Wilewee/A3EPS/Firmware/README.md

All STM32 code goes here
TODO: Write something meaningful here
