Wilewee/A3EPS/PCB_Design/1 _ fixed with 07mm vias/FULL_PCBs/FINAL/1/info.txt

Tilauksen tiedot:

Designit:
PCB1.zip ja PCB2.zip (gerberit)
Molemmista 5kpl kopioita

 levyn koko < 100mm x 100mm 
 paksuus 1.6mm
 kuparin paksuus 35 µm (halvin)
 kerroksia 2
 Pienin läpiviennin reikä 0.7mm

 Ei JEP:tta tai kuvioita
 Ei panelointia tai sahausta
