Wilewee/A3EPS/Documentation/EPS_IO_pins.txt

// Boost input (ADC)
I1_IN
I2_IN
I3_IN

V1_IN
V2_IN
V3_IN

// Boost output (ADC)
I1_OUT
I2_OUT
I3_OUT

// Bus output (ADC)
I_5V_BUS
I_3V6_BUS

I_BATT1
I_BATT2

// Battery temperature (ADC)
TEMP_BATT1
TEMP_BATT2

// Switch (GPIO)
MAIN_PWR_SW

BATT1_BUS_SW
BATT2_BUS_SW

5V_BUS_SW
3V6_BUS_SW

// DAC (I2C)
SDA
SCL
LDAC (GPIO)

// CAN
CAN1_H
CAN1_L

CAN2_H
CAN2_L

// Debug
SWCLK
SWDIO
NRST

USART_TX
USART_RX

// Oscillator
RCC_OSC_IN
RCC_OSC_OUT
