Wilewee/A3EPS/Documentation/Flowchart.png

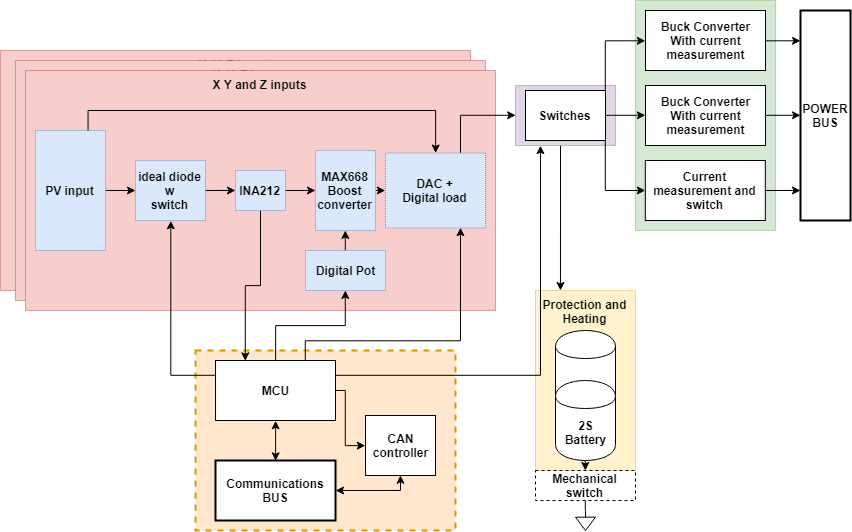
Documentation/Flowchart.png
