Wilewee/A3EPS/EPS/BOM1.png

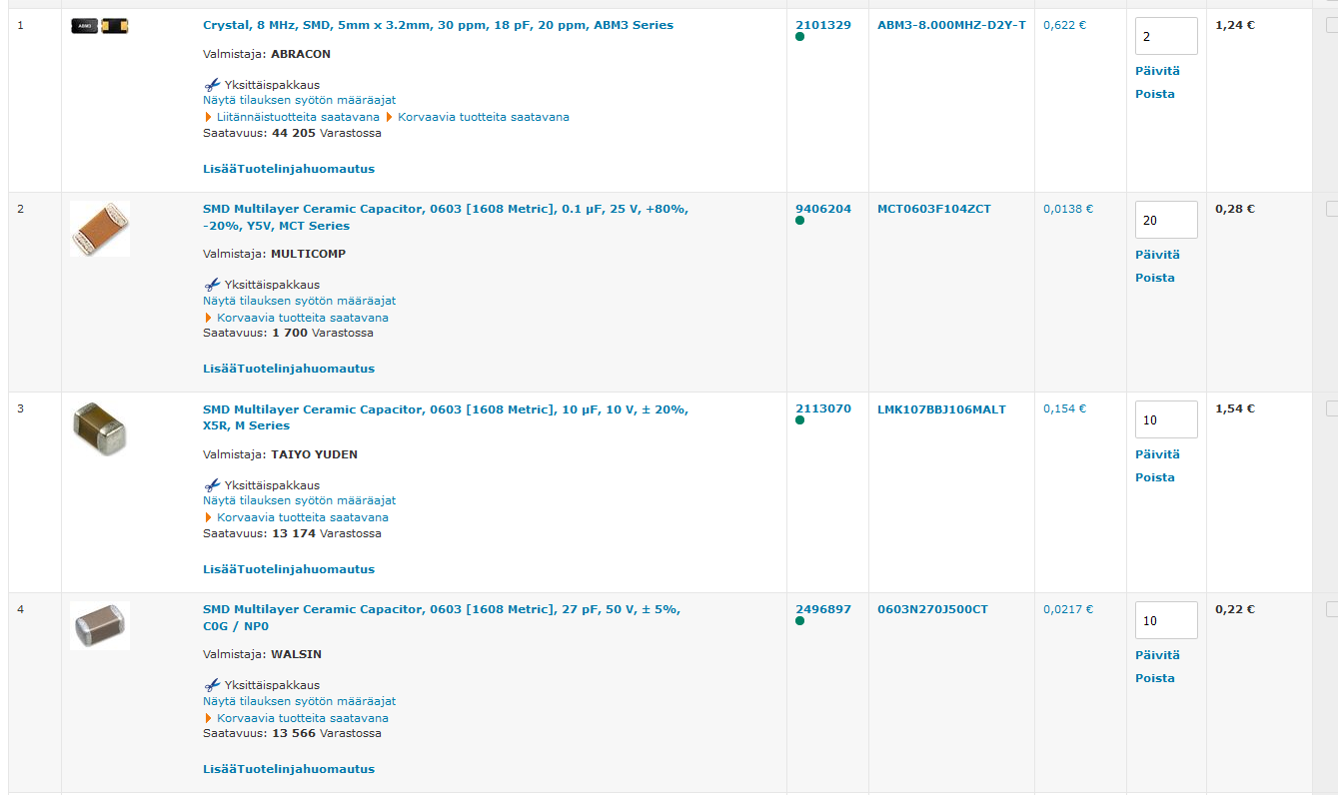
EPS/BOM1.png
