Wilewee/A3EPS/EPS/BOM3.png

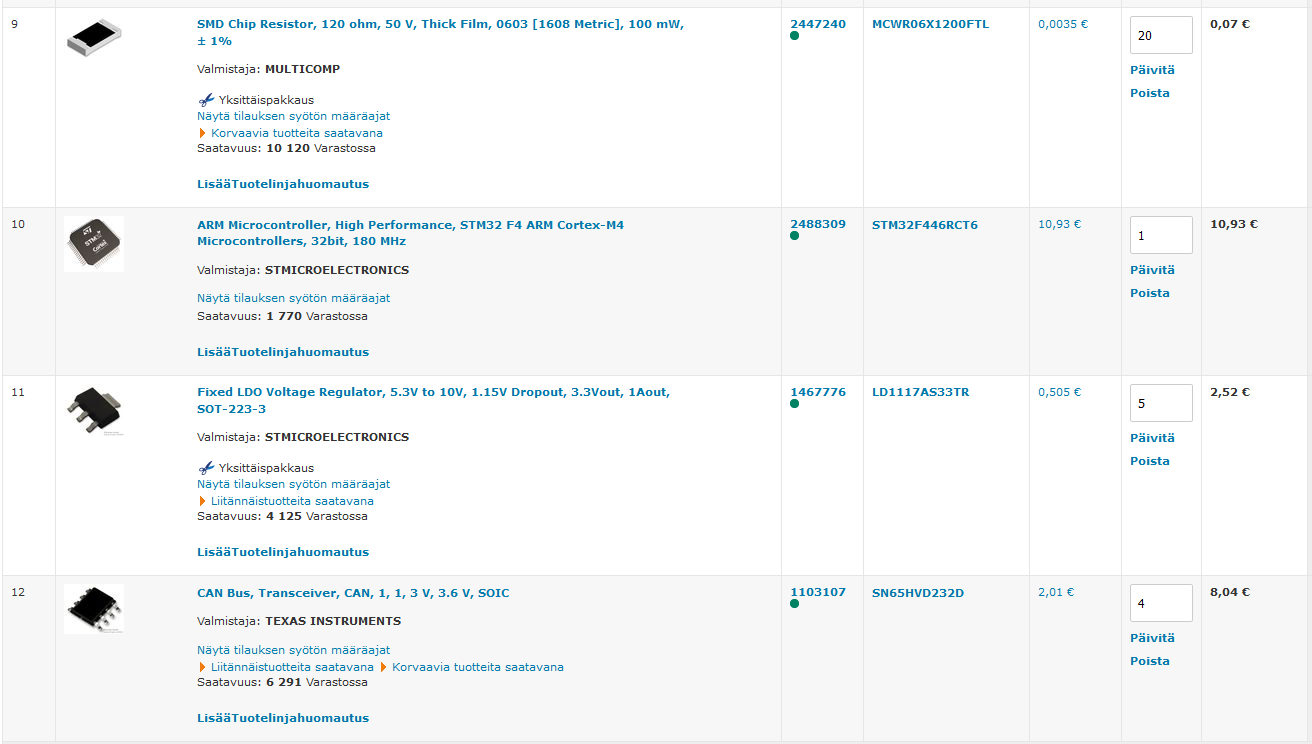
EPS/BOM3.png
