Wilewee/A3EPS/PCB_Design/1 _ fixed with 07mm vias/max1771_BOOST/nighthawk250v4propguardL.stl

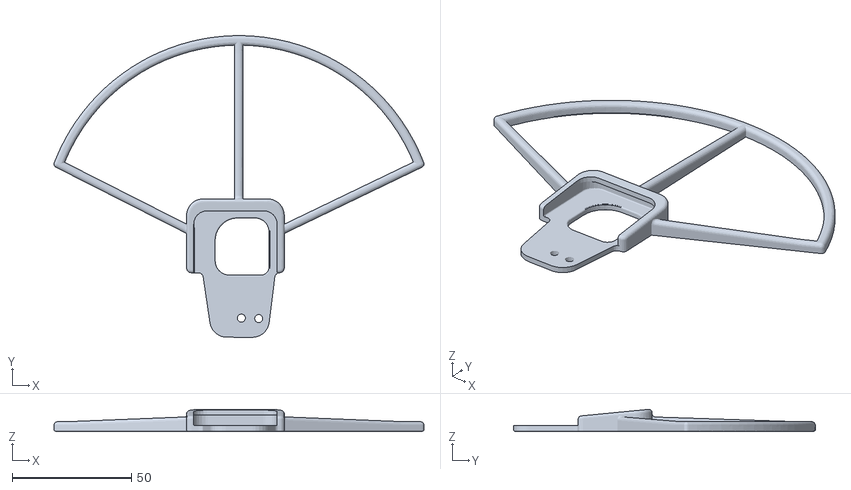
[picture p4: CAD file, 2018-01-24]
PCB_Design/1 _ fixed with 07mm vias/max1771_BOOST/nighthawk250v4propguardL.stl
155.2 x 126.6 x 9.37
