Wilewee/A3EPS/PCB_Design/1 _ fixed with 07mm vias/INA139/pdf/INA139.pdf

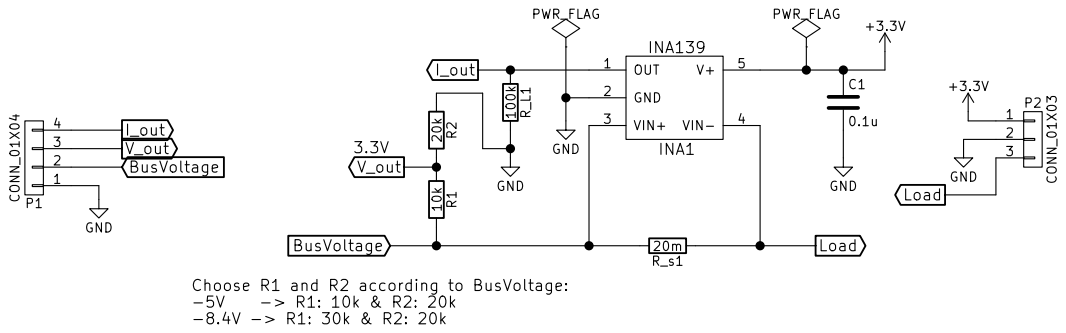
[picture p5: page 1]

PWR_FLAG Choose R1 and R2 according to BusVoltage: -5V -> R1: 10k & R2: 20k

Id: 1/1 Title: INA139 & Voltage Divider for Voltage Measurement File: INA139.sch Sheet: /
