Wilewee/A3EPS/PCB_Design/1 _ fixed with 07mm vias/max1771_BOOST/max1771-F.Cu.pdf

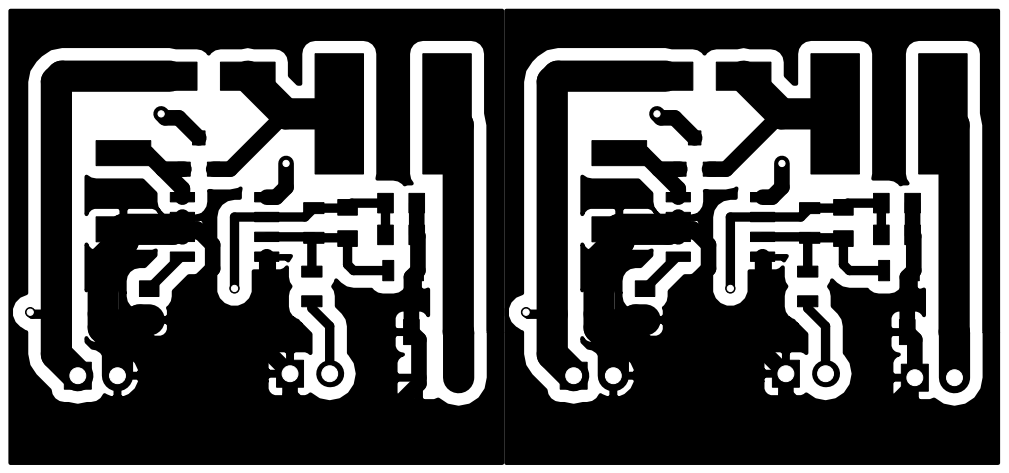
[picture p6: page 1]
