Wilewee/A3EPS/PCB_Design/1 _ fixed with 07mm vias/Max668_BOOST/Max668_2-B.Cu.pdf

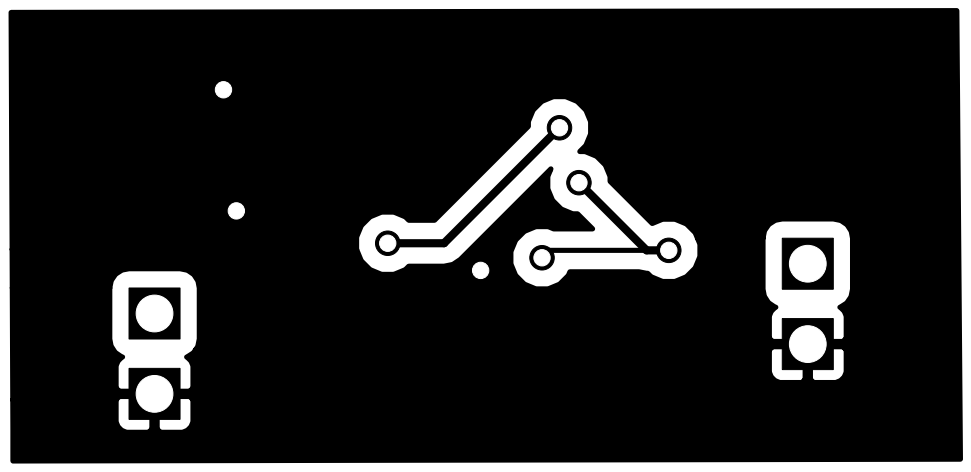
[picture p7: page 1]
