Wilewee/A3EPS/PCB_Design/1 _ fixed with 07mm vias/Max668_BOOST/Max668_2-F.Cu.pdf

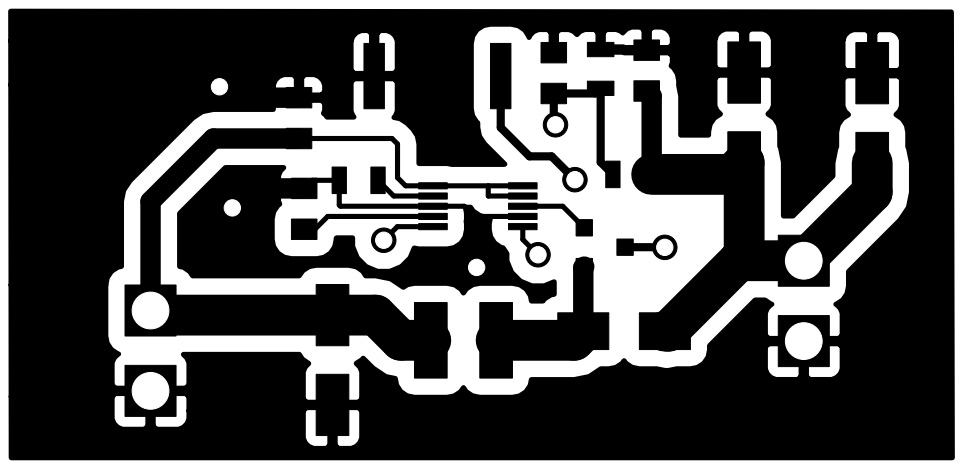
[picture p8: page 1]
