Wilewee/A3EPS/PCB_Design/1 _ fixed with 07mm vias/INA220_DAC121C081/pdf/INA220_DAC121C081.pdf

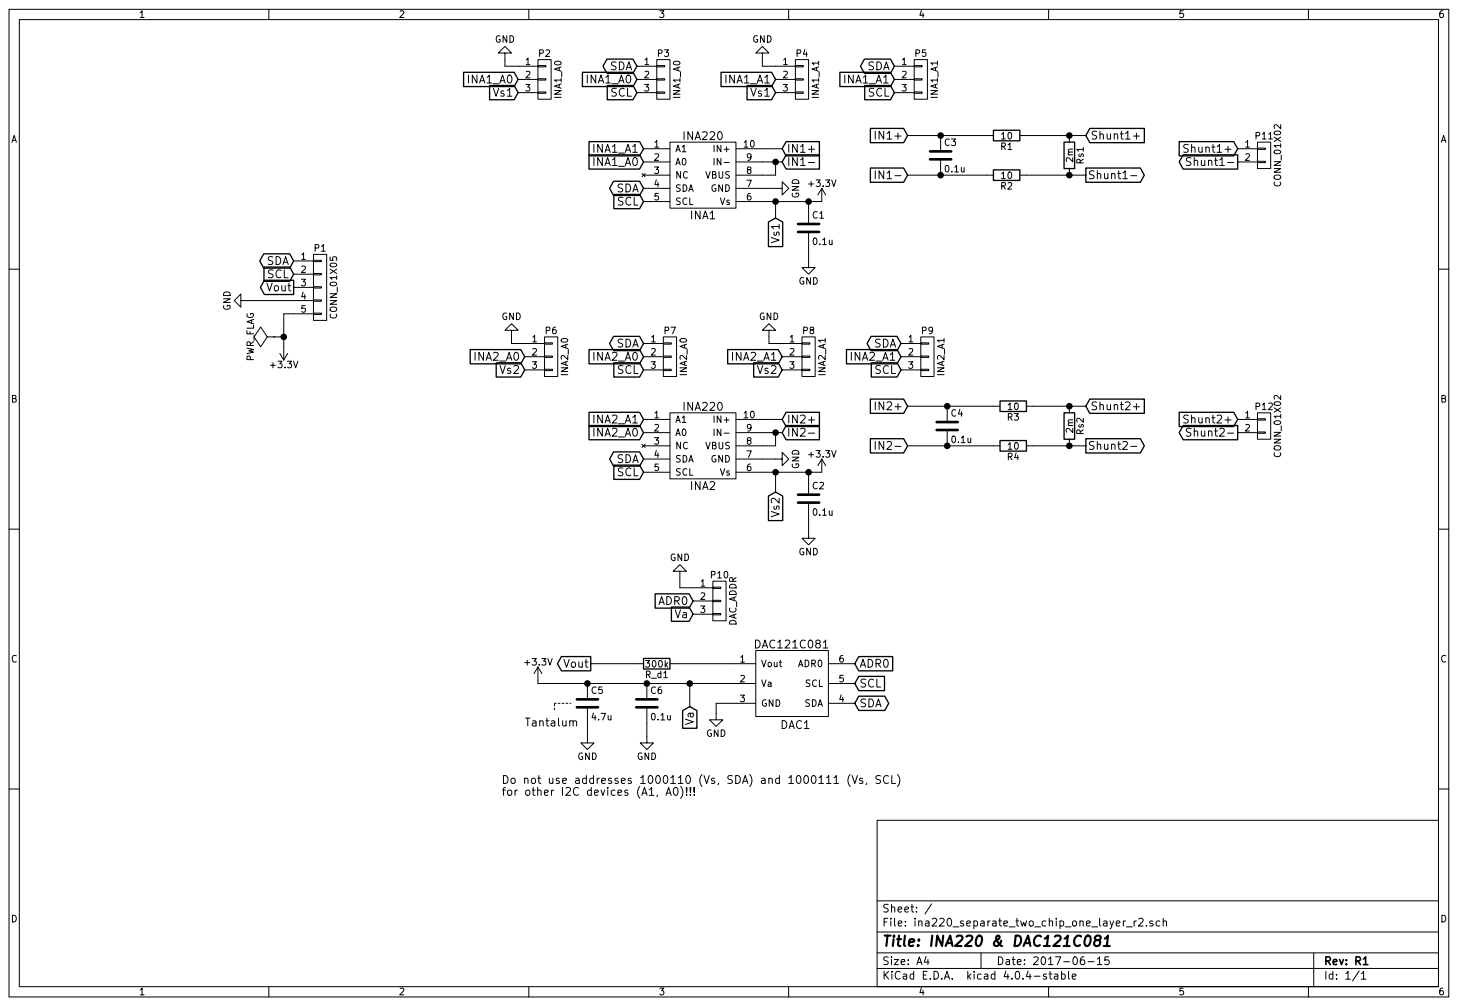
[picture p9: page 1]
