Wilewee/A3EPS/PCB_Design/1 _ fixed with 07mm vias/LT3080_and_CAN_transceiver/pdf/LT3080_and_CAN_transceiver.pdf

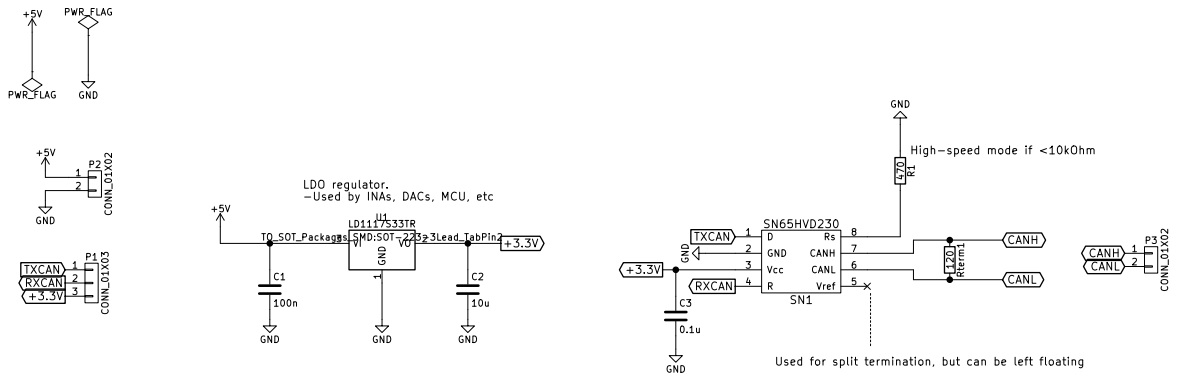
[picture p10: page 1]

Used for split termination, but can be left floating
