Wilewee/A3EPS/PCB_Design/1 _ fixed with 07mm vias/max1771_BOOST/negative/max1771-F.Cu.pdf

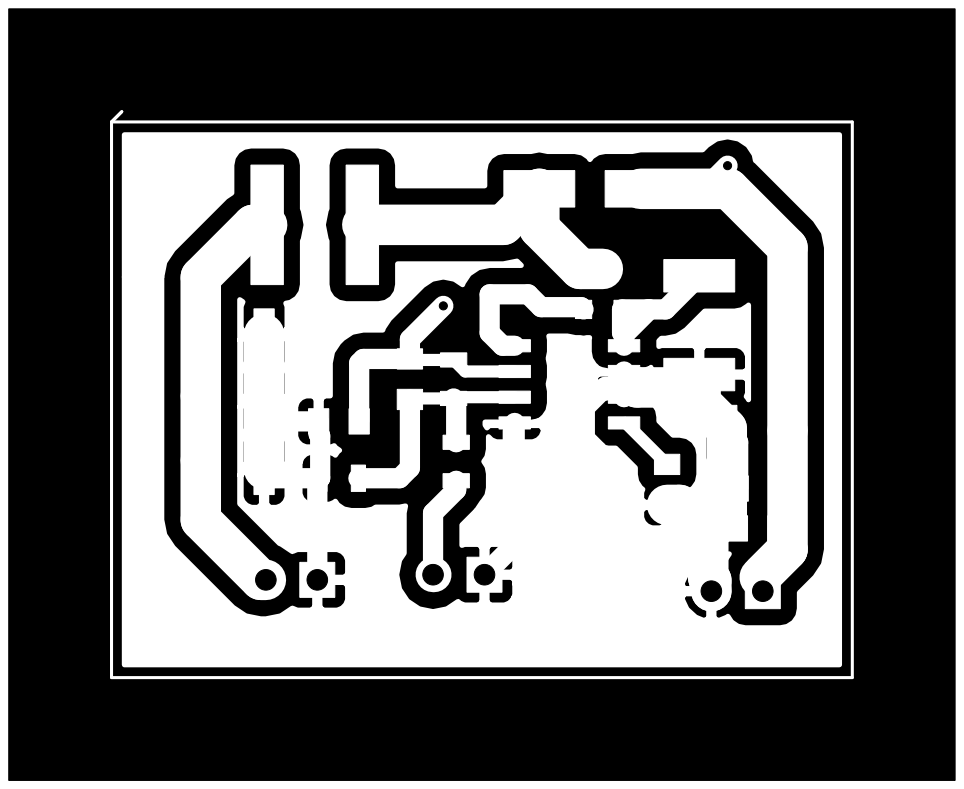
[picture p11: page 1]
