Wilewee/A3EPS/EPS/CAN_transceivers-STM32_block-CAN_transceivers.pdf

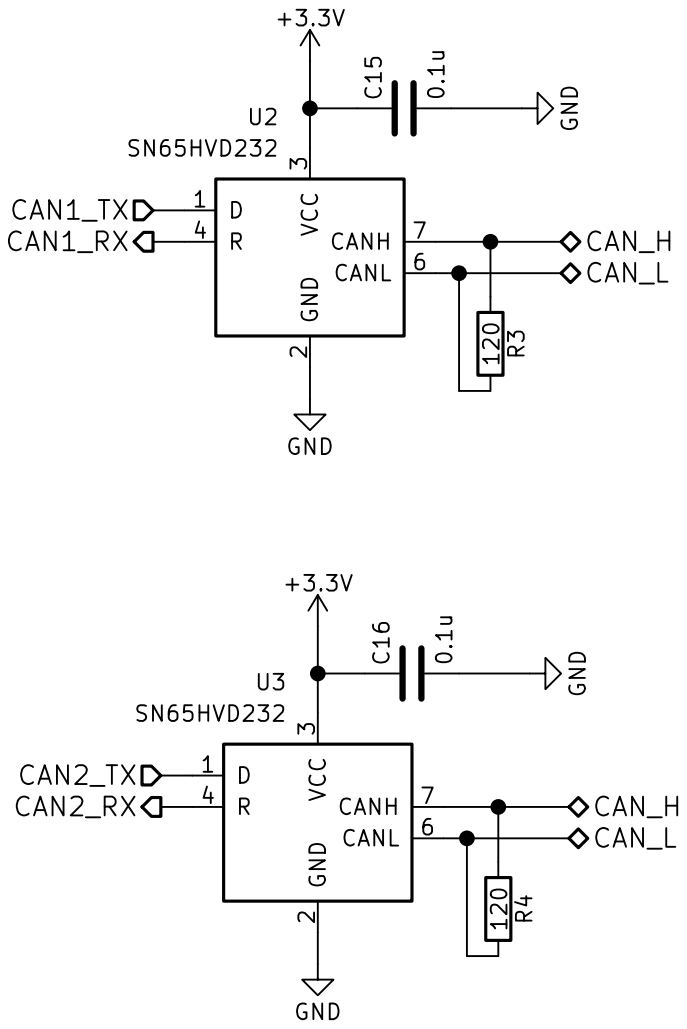
[picture p12: page 1]
