Wilewee/A3EPS/EPS/STM32_block-STM32_block.pdf

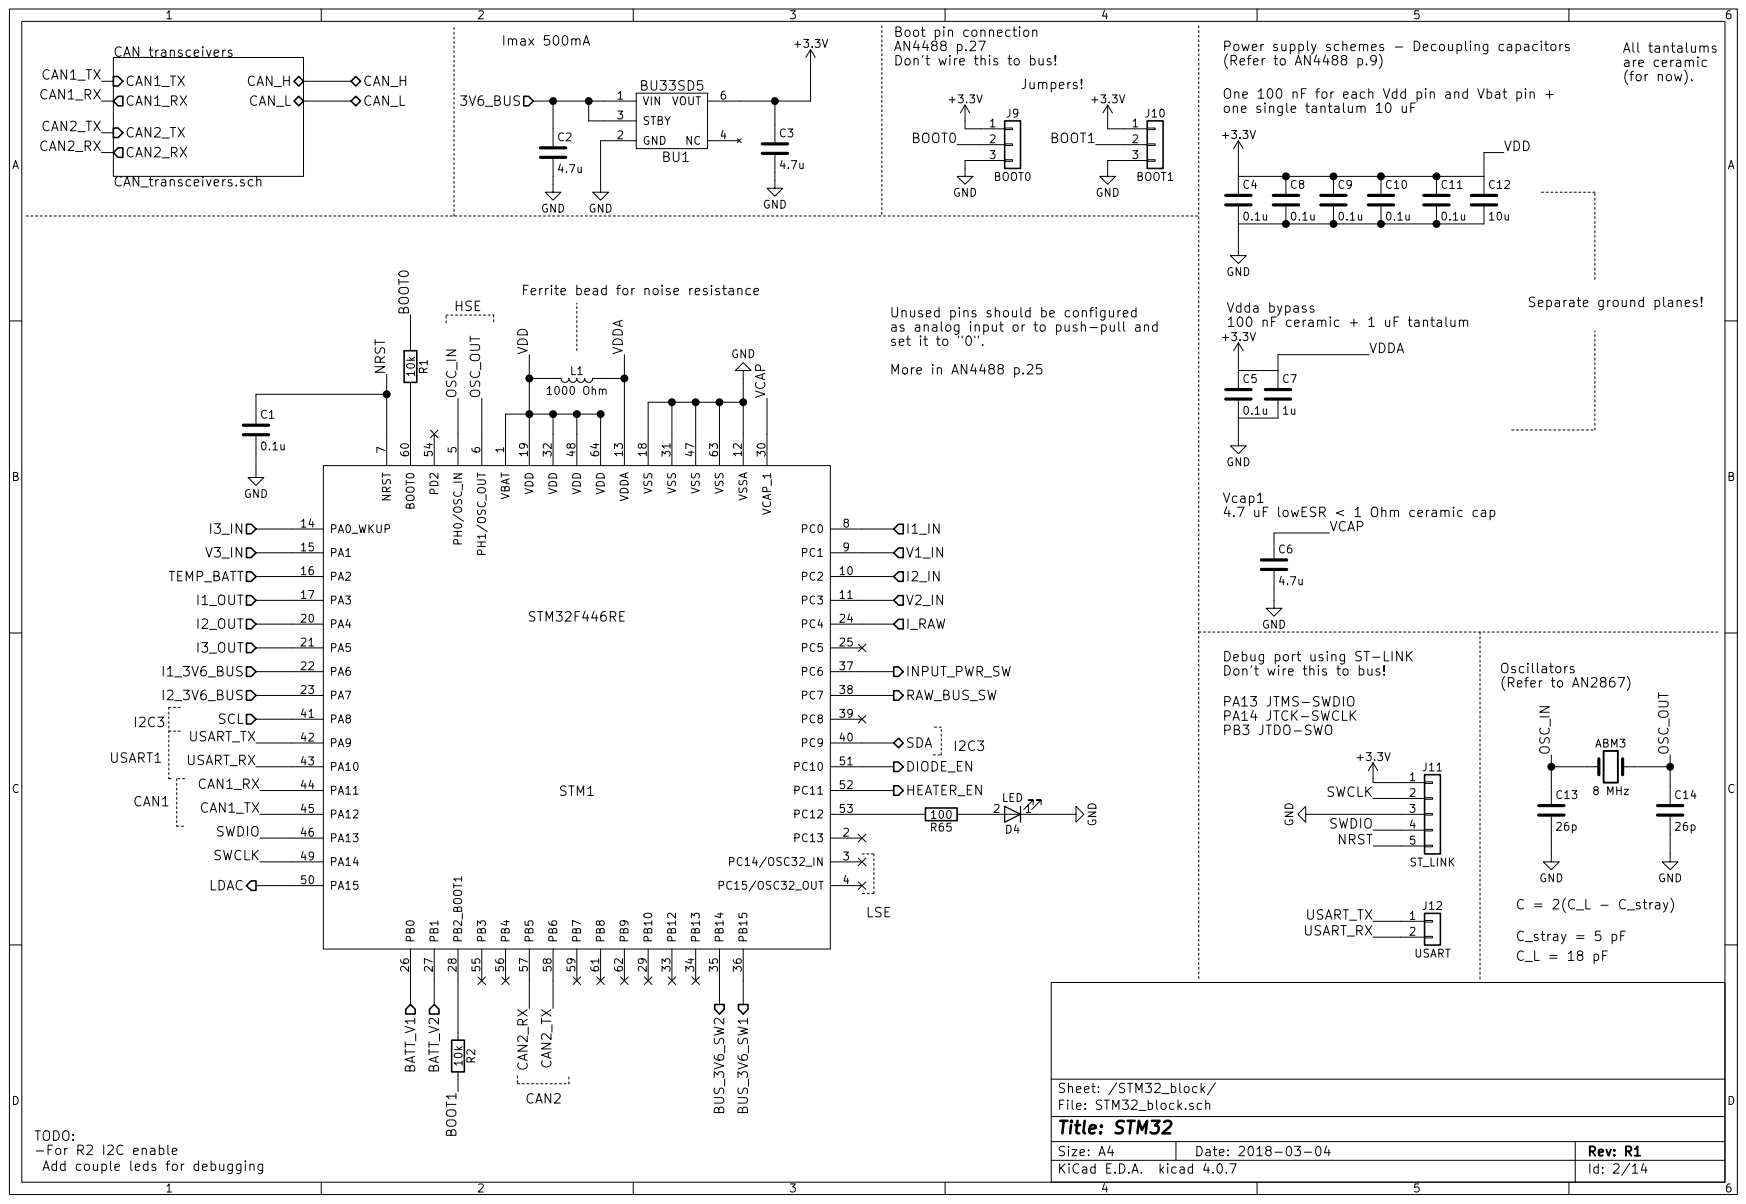
[picture p13: page 1]
