Wilewee/A3EPS/PCB_Design/FULL_PCB/Full_PCB.kicad_pcb

## KiCad design PCB_Design/FULL_PCB/Full_PCB.kicad_pcb (2018-02-04)

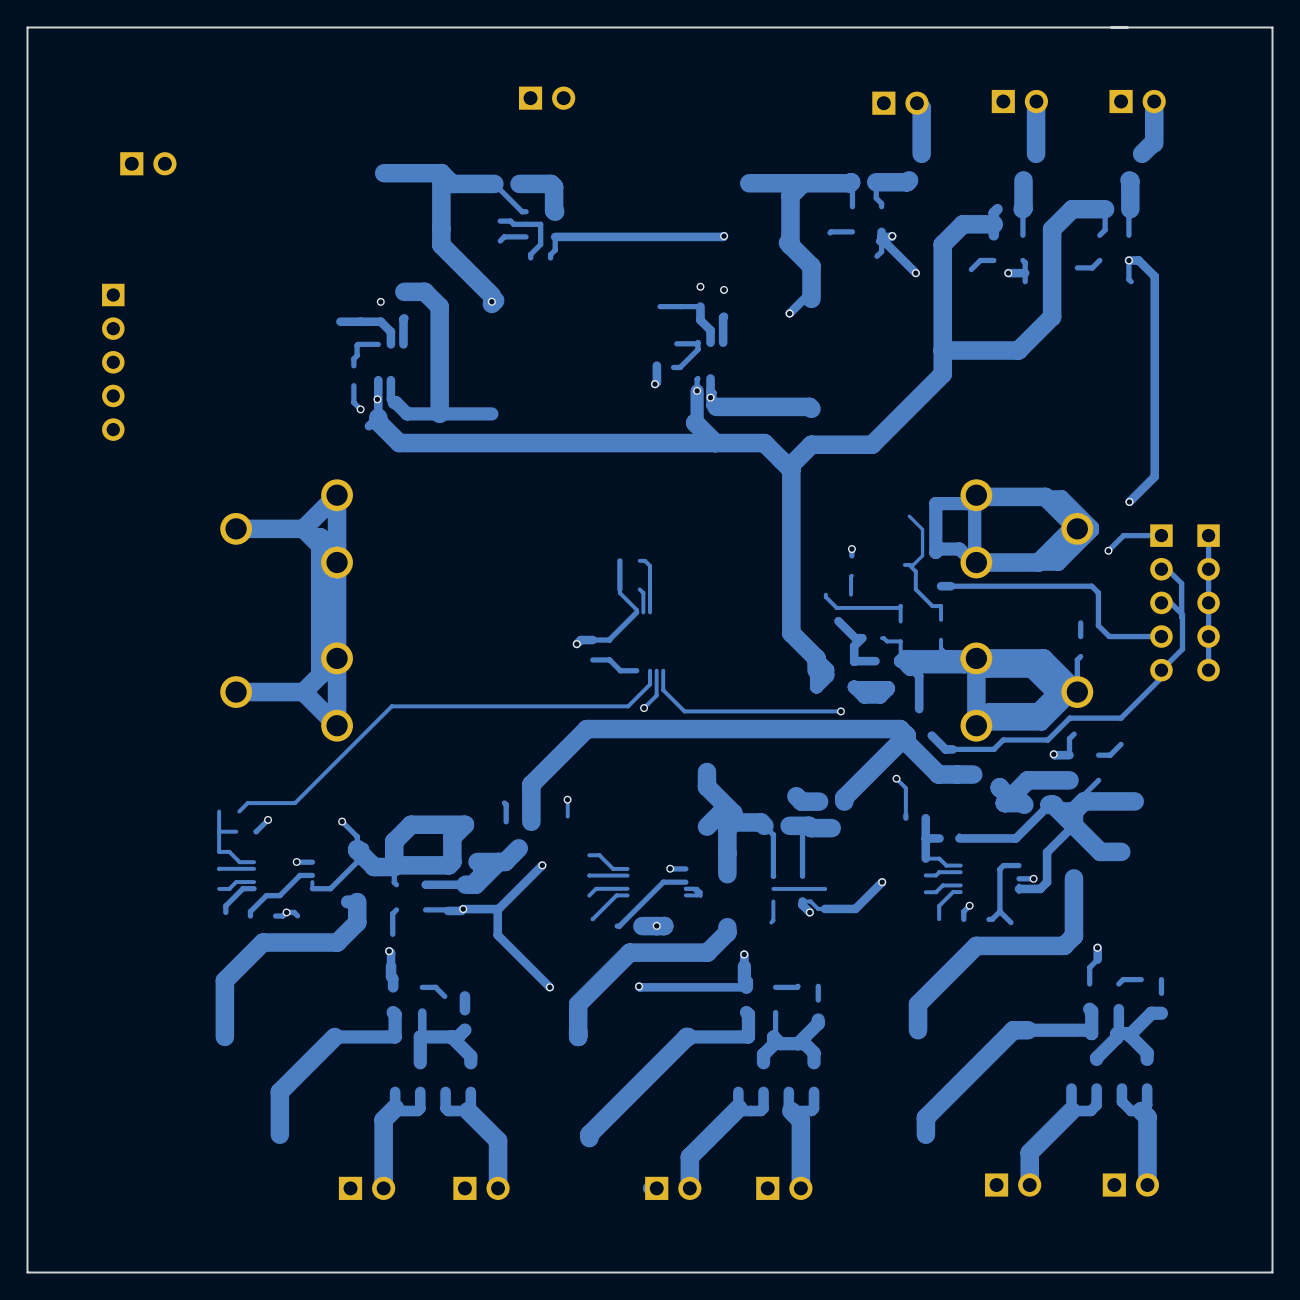
[picture p16: board Full_PCB.kicad_pcb from above]

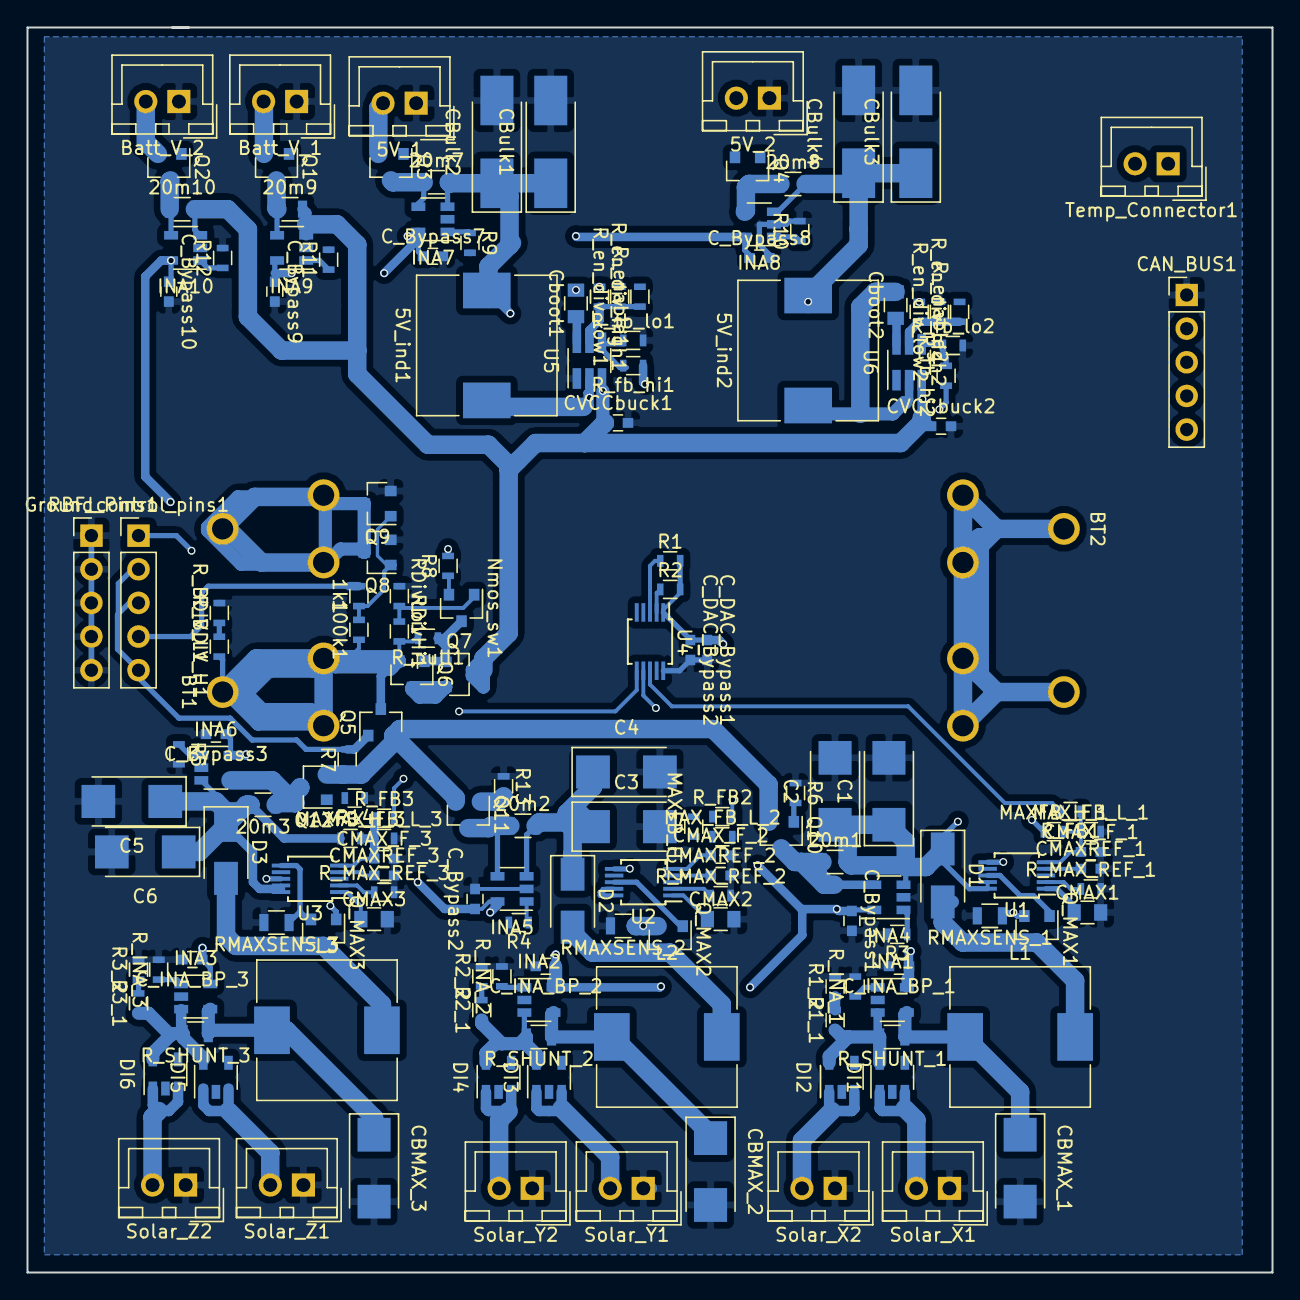
[picture p17: board Full_PCB.kicad_pcb from below]

Board: 4 copper layers, 94.0 x 94.0 mm, 165 parts (165 on the bottom side), 92 nets.

Parts:
1k1, 100k1: R; R_0603
5V_1, 5V_2: Jst_Conn; JST_XH_B02B-XH-A_02x2.50mm_Straight
5V_ind1, 5V_ind2: 10u; L_10.4x10.4_H4.8
20m1, 20m2, 20m3, 20m7, 20m8, 20m9, 20m10: R_Shunt; R_0805
BT1, BT2: Battery_Cell; 18650_Holder_FULL
Batt_V_1, Batt_V_2: Jst_Conn; JST_XH_B02B-XH-A_02x2.50mm_Straight
C1, C2, C3, C4, C5, C6: CP; CP_Tantalum_Case-C_EIA-6032-28_Reflow
CAN_BUS1: 5_pin_2.56; Socket_Strip_Straight_1x05_Pitch2.54mm
CBMAX_1, CBMAX_2, CBMAX_3: 68uF; CP_Tantalum_Case-C_EIA-6032-28_Reflow
CBulk1, CBulk2, CBulk3, CBulk4: C; CP_Tantalum_Case-C_EIA-6032-28_Hand
CMAX1, CMAX2, CMAX3: 1uF; C_0805
CMAXREF_1, CMAXREF_2, CMAXREF_3: .22uF; C_0603
CMAX_F_1, CMAX_F_2, CMAX_F_3: 220pF; C_0603
CVCCbuck1, CVCCbuck2: 10u; C_0603
C_Bypass1, C_Bypass2, C_Bypass3, C_Bypass7, C_Bypass8, C_Bypass9, C_Bypass10: .1u; C_0603
C_DAC_Bypass1, C_DAC_Bypass2: C; C_0603
C_INA_BP_1, C_INA_BP_2, C_INA_BP_3: .1u; C_0603
Cboot1, Cboot2: .1uF; C_0805
D1, D2, D3: D_Schottky; D_SMA
DI1, DI2, DI3, DI4, DI5, DI6: MAX40200; SOT-23-5
Ground_Pins1: 2.56_socket_male; Socket_Strip_Straight_1x05_Pitch2.54mm
INA1, INA2, INA3, INA4, INA5, INA6, INA7, INA8, INA9, INA10: INA139; SOT-23-5
L1, L2, L3: L_Small; L_10.4x10.4_H4.8
MAXFB_H_1, MAXFB_H_2, MAXFB_H_3: 100k; R_0603
MAX_FB_L_1, MAX_FB_L_2, MAX_FB_L_3: 22k; R_0603
Nmos_sw1: Logic level Nch mosfet; SOT-23
Q1, Q2, Q3, Q4, Q8, Q9: Q_NMOS_GSD; SOT-23
Q5, Q6, Q7, Q10, Q11, Q12: Q_PMOS_GSD; SOT-23
Q_MAX1, Q_MAX2, Q_MAX3: Q_NMOS_GSD; SOT-23
R1, R2: 10k; R_0603
R1_1, R2_1, R3, R3_1, R4, R5, R9, R10, R11, R12: 100k; R_0603
R1_2, R2_2, R3_2: 200k; R_0603
R6, R13, R14: 220k; R_0603
R7, R8: R; R_0603
RBF_control_pins1: 5_pin_2.56; Socket_Strip_Straight_1x05_Pitch2.54mm
RDivHi1: R; R_0603
RDivLo1: R; R_0603
RMAXSENS_1, RMAXSENS_2, RMAXSENS_3: 0.02; R_0805
R_BDIV_H1: 220k; R_0603
R_BDIV_L1: 100k; R_0603
R_FB1, R_FB2, R_FB3: 100k; R_0603
R_INA_1, R_INA_2, R_INA_3: 100k; R_0603
R_MAX_REF_1, R_MAX_REF_2, R_MAX_REF_3: 100k; R_0603
R_SHUNT_1, R_SHUNT_2, R_SHUNT_3: 20m; R_0805
R_en_div_high1, R_en_div_high2: R; R_0603
R_en_div_low1, R_en_div_low2: R; R_0603
R_enable1, R_enable2: R; R_0603
R_fb_hi1, R_fb_hi2: R; R_0603
R_fb_lo1, R_fb_lo2: R; R_0603
R_pull1: R; R_0603
Solar_X1, Solar_X2: JST_Connector; JST_XH_B02B-XH-A_02x2.50mm_Straight
Solar_Y1, Solar_Y2: JST_Connector; JST_XH_B02B-XH-A_02x2.50mm_Straight
Solar_Z1, Solar_Z2: JST_Connector; JST_XH_B02B-XH-A_02x2.50mm_Straight
Temp_Connector1: JST_conn; JST_XH_B02B-XH-A_02x2.50mm_Straight
U1, U2, U3: MAX668; MSOP-10_3x3mm_Pitch0.5mm
U4: MCP4728; MSOP-10_3x3mm_Pitch0.5mm
U5, U6: TPS54302; SOT-23-6_Handsoldering

Connections:
/3V3: C_Bypass1.1, C_Bypass2.1, C_Bypass3.1, C_Bypass7.1, C_Bypass8.1, C_Bypass9.1, C_Bypass10.1, C_DAC_Bypass1.1, C_DAC_Bypass2.1, C_INA_BP_1.1, C_INA_BP_2.1, C_INA_BP_3.1, INA1.5, INA2.5, INA3.5, INA4.5, INA5.5, INA6.5, INA7.5, INA8.5, INA9.5, INA10.5, R1.2, R2.2, U4.1
/5V_1: 5V_1.2, Q3.2
/5V_2: 5V_2.2, Q4.2
/A_1_I: INA1.1, R_INA_1.1
/A_1_O: INA6.1, R5.1
/A_2_I: INA2.1, R_INA_2.1
/A_3_I: INA3.1, R_INA_3.1
/A_3_O: INA4.1, R3.1
/Batt_V_1: Batt_V_1.2, Q1.2
/Batt_V_2: Batt_V_2.2, Q2.2
/Batt_voltage_divided: R_BDIV_H1.2, R_BDIV_L1.1
/Connectors And Inputs/Ideal_Diodes/X+: DI1.1, DI1.3, Solar_X1.2
/Connectors And Inputs/Ideal_Diodes/X-: DI2.1, DI2.3, Solar_X2.2
/Connectors And Inputs/Ideal_Diodes/Y+: DI3.1, DI3.3, Solar_Y1.2
/Connectors And Inputs/Ideal_Diodes/Y-: DI4.1, DI4.3, Solar_Y2.2
/Connectors And Inputs/Ideal_Diodes/Z+: DI5.1, DI5.3, Solar_Z1.2
/Connectors And Inputs/Ideal_Diodes/Z-: DI6.1, DI6.3, Solar_Z2.2
/Curr_5V_1: INA7.1, R9.1
/Curr_5V_2: INA8.1, R10.1
/Curr_Vbat_1: INA9.1, R11.1
/Curr_Vbat_2: INA10.1, R12.1
/Input/Boost_Converters/I_in_1: CBMAX_1.1, INA1.4, L1.1, R_SHUNT_1.1
/Input/Boost_Converters/I_in_2: CBMAX_2.1, INA2.4, L2.1, R_SHUNT_2.1
/Input/Boost_Converters/I_in_3: CBMAX_3.1, INA3.4, L3.1, R_SHUNT_3.1
/Input/Boost_Converters/MAX668/FB: CMAX_F_1.1, MAXFB_H_1.2, MAX_FB_L_1.1, R_FB1.1, U1.5
/Input/Boost_Converters/MAX668_2/FB: CMAX_F_2.1, MAXFB_H_2.2, MAX_FB_L_2.1, R_FB2.1, U2.5
/Input/Boost_Converters/MAX668_3/FB: CMAX_F_3.1, MAXFB_H_3.2, MAX_FB_L_3.1, R_FB3.1, U3.5
/Input/DAC/Dac_1: R_FB1.2, U4.8
/Input/DAC/Dac_2: R_FB2.2, U4.7
/Input/DAC/Dac_3: R_FB3.2, U4.6
/Input/InaOutput/INA_out/I_out: 20m1.1, INA4.4, Q10.3
/Input/InaOutput/INA_out_2/I_out: 20m2.1, INA5.4, Q11.3
/Input/InaOutput/INA_out_2/Ina_Analog: INA5.1, R4.1
/Input/InaOutput/INA_out_3/I_out: 20m3.1, INA6.4, Q12.3
/Input/InaOutput/I_in_1: 20m1.2, C1.1, C2.1, D1.1, INA4.3, MAXFB_H_1.1, U1.9, U1.10
/Input/InaOutput/I_in_2: 20m2.2, C3.1, C4.1, D2.1, INA5.3, MAXFB_H_2.1, U2.9, U2.10
/Input/InaOutput/I_in_3: 20m3.2, C5.1, C6.1, D3.1, INA6.3, MAXFB_H_3.1, U3.9, U3.10
/Input/InaOutput/PWM_CTRL: Q10.1, Q11.1, Q12.1, R6.2, R13.2, R14.2
/Input/Output_1: Q5.2, Q10.2, Q11.2, Q12.2, R7.1
/MCU_POWER_SW: Nmos_sw1.1, RDivHi1.1, RDivLo1.2
/OUTPUT/5VBuck1/5V_OUT: 5V_ind1.2, 20m7.2, CBulk1.1, CBulk2.1, INA7.3, R_fb_hi1.1
/OUTPUT/5VBuck2/5V_OUT: 5V_ind2.2, 20m8.2, CBulk3.1, CBulk4.1, INA8.3, R_fb_hi2.1
/OUTPUT/INA_BV_2/I_out: 20m10.1, INA10.4, Q2.3
/OUTPUT/Ina_3V6_Out/I_out: 20m8.1, INA8.4, Q4.3
/OUTPUT/Ina_5V_Out/I_out: 20m7.1, INA7.4, Q3.3
/OUTPUT/Ina_BV_1/I_out: 20m9.1, INA9.4, Q1.3
/OUTPUT/POWER_INPUT: 20m9.2, 20m10.2, CVCCbuck1.1, CVCCbuck2.1, INA9.3, INA10.3, Q7.3, R_en_div_high1.1, R_en_div_high2.1, U5.3, U6.3
/SCL: R2.1, U4.2
/SDA: R1.1, U4.3
/V1: R1_1.2, R1_2.1
/V2: R2_1.2, R2_2.1
/V3: R3_1.2, R3_2.1
Battery_+: 100k1.1, BT1.1, Q5.3, Q6.2, RDivHi1.2, R_BDIV_H1.1, R_pull1.2
Battery_-: BT2.2, Q8.3, Q9.3
Battery_middle: BT1.2, BT2.1
GND: 5V_1.1, 5V_2.1, Batt_V_1.1, Batt_V_2.1, C1.2, C2.2, C3.2, C4.2, C5.2, C6.2, CAN_BUS1.1, CBMAX_1.2, CBMAX_2.2, CBMAX_3.2, CBulk1.2, CBulk2.2, CBulk3.2, CBulk4.2, CMAX1.2, CMAX2.2, CMAX3.2, CMAXREF_1.2, CMAXREF_2.2, CMAXREF_3.2, CMAX_F_1.2, CMAX_F_2.2, CMAX_F_3.2, CVCCbuck1.2, CVCCbuck2.2, C_Bypass1.2, C_Bypass2.2, C_Bypass3.2, C_Bypass7.2, C_Bypass8.2, C_Bypass9.2, C_Bypass10.2, C_DAC_Bypass1.2, C_DAC_Bypass2.2, C_INA_BP_1.2, C_INA_BP_2.2, C_INA_BP_3.2, DI1.2, DI2.2, DI3.2, DI4.2, DI5.2, DI6.2, Ground_Pins1.1, Ground_Pins1.2, Ground_Pins1.3, Ground_Pins1.4, Ground_Pins1.5, INA1.2, INA2.2, INA3.2, INA4.2, INA5.2, INA6.2, INA7.2, INA8.2, INA9.2, INA10.2, MAX_FB_L_1.2, MAX_FB_L_2.2, MAX_FB_L_3.2, Q8.2, Q9.2, R1_2.2, R2_2.2, R3.2, R3_2.2, R4.2, R5.2, R6.1, R9.2, R10.2, R11.2, R12.2, R13.1, R14.1, RDivLo1.1, RMAXSENS_1.2, RMAXSENS_2.2, RMAXSENS_3.2, R_BDIV_L1.2, R_INA_1.2, R_INA_2.2, R_INA_3.2, R_MAX_REF_1.2, R_MAX_REF_2.2, R_MAX_REF_3.2, R_en_div_low1.2, R_en_div_low2.2, R_fb_lo1.2, R_fb_lo2.2, Solar_X1.1, Solar_X2.1, Solar_Y1.1, Solar_Y2.1, Solar_Z1.1, Solar_Z2.1, U1.3, U1.7, U2.3, U2.7, U3.3, U3.7, U4.10, U5.1, U6.1
GND_DSW: 1k1.2, RBF_control_pins1.4
unnamed: 5V_ind1.1, Cboot1.2, U5.2
unnamed: 5V_ind2.1, Cboot2.2, U6.2
unnamed: 1k1.1, 100k1.2, Q8.1, Q9.1
unnamed: CMAX1.1, U1.1
unnamed: CMAX2.1, U2.1
unnamed: CMAX3.1, U3.1
unnamed: CMAXREF_1.1, U1.4
unnamed: CMAXREF_2.1, U2.4
unnamed: CMAXREF_3.1, U3.4
unnamed: Cboot1.1, U5.6
unnamed: Cboot2.1, U6.6
unnamed: D1.2, L1.2, Q_MAX1.3
unnamed: D2.2, L2.2, Q_MAX2.3
unnamed: D3.2, L3.2, Q_MAX3.3
unnamed: Nmos_sw1.2, R8.1
unnamed: Nmos_sw1.3, Q6.1, Q7.1, R_pull1.1
unnamed: Q6.3, Q7.2
unnamed: Q_MAX1.1, U1.8
unnamed: Q_MAX1.2, RMAXSENS_1.1, U1.6
unnamed: Q_MAX2.1, U2.8
unnamed: Q_MAX2.2, RMAXSENS_2.1, U2.6
unnamed: Q_MAX3.1, U3.8
unnamed: Q_MAX3.2, RMAXSENS_3.1, U3.6
unnamed: R_MAX_REF_1.1, U1.2
unnamed: R_MAX_REF_2.1, U2.2
unnamed: R_MAX_REF_3.1, U3.2
unnamed: R_en_div_high1.2, R_en_div_low1.1, R_enable1.1, U5.5
unnamed: R_en_div_high2.2, R_en_div_low2.1, R_enable2.1, U6.5
unnamed: R_fb_hi1.2, R_fb_lo1.1, U5.4
unnamed: R_fb_hi2.2, R_fb_lo2.1, U6.4
RBF1: Q5.1, R7.2, RBF_control_pins1.2, RBF_control_pins1.3, RBF_control_pins1.5
RBF2: R8.2, RBF_control_pins1.1
X+: DI1.5, DI2.5, INA1.3, R1_1.1, R_SHUNT_1.2
Y+: DI3.5, DI4.5, INA2.3, R2_1.1, R_SHUNT_2.2
Z+: DI5.5, DI6.5, INA3.3, R3_1.1, R_SHUNT_3.2
