Wilewee/A3EPS/PCB_Design/1 _ fixed with 07mm vias/INA220_DAC121C081/ina220_separate_two_chip_one_layer_r2.kicad_pcb

## KiCad design PCB_Design/1 _ fixed with 07mm vias/INA220_DAC121C081/ina220_separate_two_chip_one_layer_r2.kicad_pcb (2018-01-24)

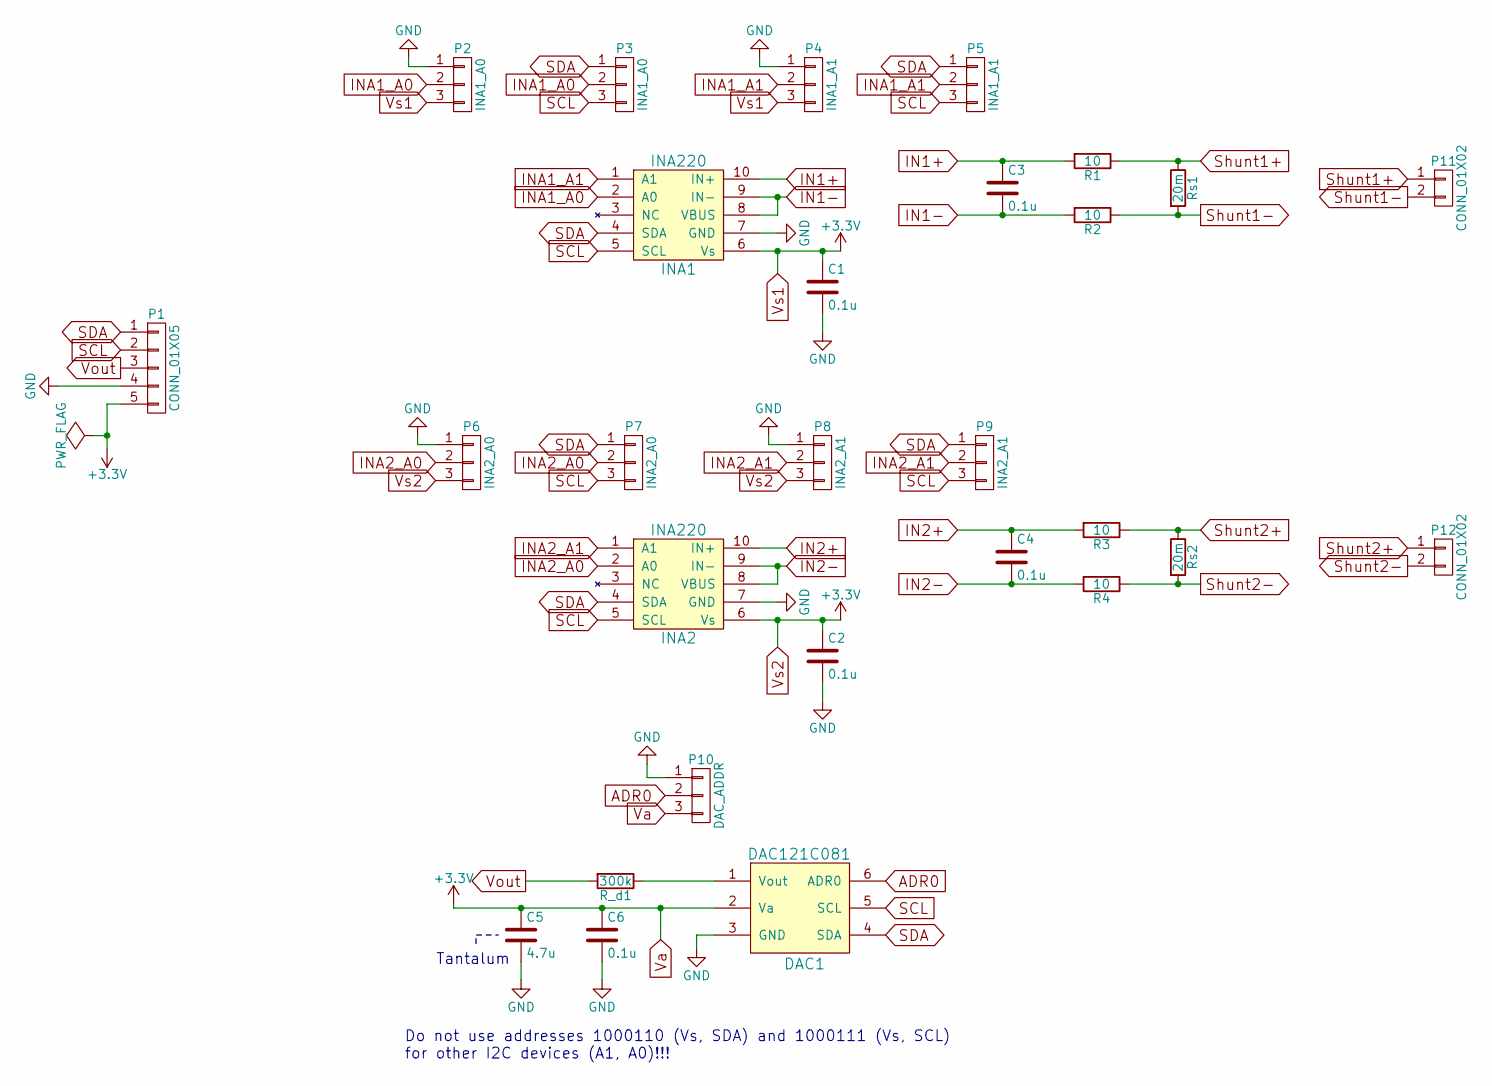
[picture p18: schematic ina220_separate_two_chip_one_layer_r2.sch, INA220 & DAC121C081]

Parts:
C1, C2, C3, C4, C6: 0.1u; C_0805_HandSoldering
C5: 4.7u; C_0805_HandSoldering
DAC1: DAC121C081; SOT-23-6
INA1, INA2: INA220; ina220__smd_footprint
P1: CONN_01X05; JST_XH_B05B-XH-A_05x2.50mm_Straight
P2, P3: INA1_A0; Pin_Header_Straight_1x03_Pitch2.54mm
P4, P5: INA1_A1; Pin_Header_Straight_1x03_Pitch2.54mm
P6, P7: INA2_A0; Pin_Header_Straight_1x03_Pitch2.54mm
P8, P9: INA2_A1; Pin_Header_Straight_1x03_Pitch2.54mm
P10: DAC_ADDR; Pin_Header_Straight_1x03_Pitch2.54mm
P11, P12: CONN_01X02; JST_XH_B02B-XH-A_02x2.50mm_Straight
R1, R2, R3, R4: 10; R_0805_HandSoldering
R_d1: 300k; R_0805_HandSoldering
Rs1, Rs2: 20m; R_1206_HandSoldering

Connections:
ADR0: DAC1.6 (ADR0), P10.2
GND: C1.2, C2.2, C5.2, C6.2, DAC1.3 (GND), INA1.7 (GND), INA2.7 (GND), P1.4, P2.1, P4.1, P6.1, P8.1, P10.1
IN1+: C3.1, INA1.10 (IN+), R1.2
IN1-: C3.2, INA1.8 (VBUS), INA1.9 (IN-), R2.2
IN2+: C4.1, INA2.10 (IN+), R3.2
IN2-: C4.2, INA2.8 (VBUS), INA2.9 (IN-), R4.2
INA1_A0: INA1.2 (A0), P2.2, P3.2
INA1_A1: INA1.1 (A1), P4.2, P5.2
INA2_A0: INA2.2 (A0), P6.2, P7.2
INA2_A1: INA2.1 (A1), P8.2, P9.2
unnamed: DAC1.1 (Vout), R_d1.1
SCL: DAC1.5 (SCL), INA1.5 (SCL), INA2.5 (SCL), P1.2, P3.3, P5.3, P7.3, P9.3
SDA: DAC1.4 (SDA), INA1.4 (SDA), INA2.4 (SDA), P1.1, P3.1, P5.1, P7.1, P9.1
Shunt1+: P11.1, R1.1, Rs1.1
Shunt1-: P11.2, R2.1, Rs1.2
Shunt2+: P12.1, R3.1, Rs2.1
Shunt2-: P12.2, R4.1, Rs2.2
Va: C1.1, C2.1, C5.1, C6.1, DAC1.2 (Va), INA1.6 (Vs), INA2.6 (Vs), P1.5, P2.3, P4.3, P6.3, P8.3, P10.3
Vout: P1.3, R_d1.2

Notes on the sheet:
Do not use addresses 1000110 (Vs, SDA) and 1000111 (Vs, SCL) for other I2C devices (A1, A0)!!!
Tantalum

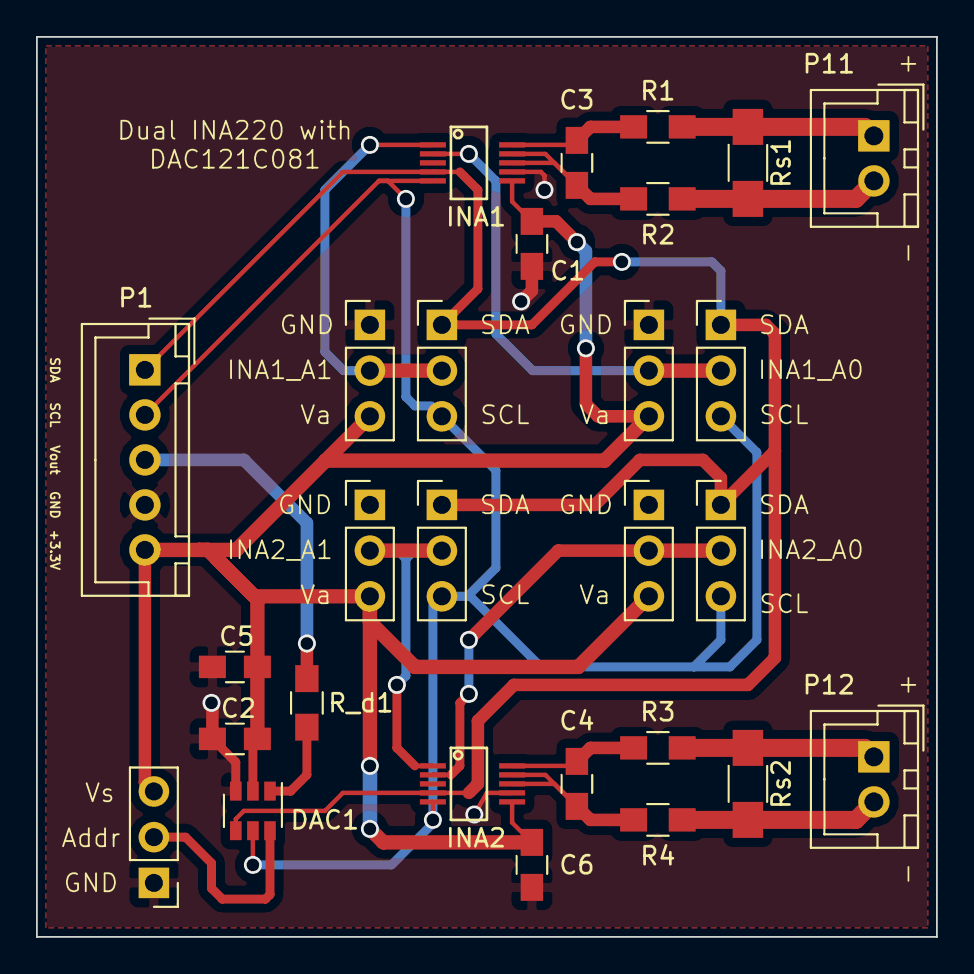
[picture p19: board ina220_separate_two_chip_one_layer_r2.kicad_pcb from above]

Board: 2 copper layers, 50.0 x 50.0 mm, 28 parts (0 on the bottom side), 19 nets.
