Wilewee/A3EPS/PCB_Design/1 _ fixed with 07mm vias/LM3485/LM3485.kicad_pcb

## KiCad design PCB_Design/1 _ fixed with 07mm vias/LM3485/LM3485.kicad_pcb (2018-01-24)

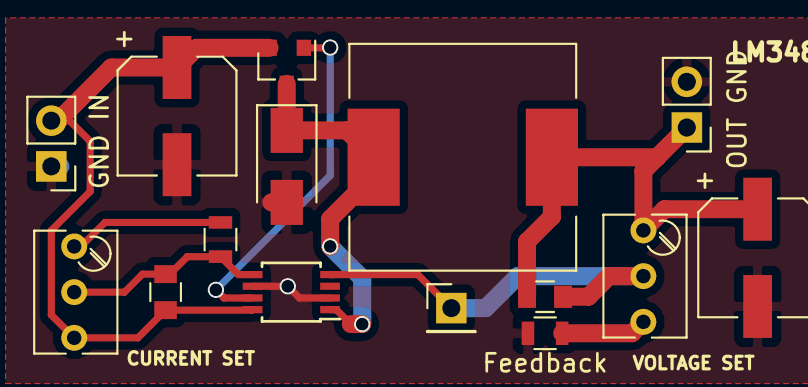
[picture p20: board LM3485.kicad_pcb from above]

Board: 2 copper layers, 15 parts (0 on the bottom side), 9 nets.

Parts:
C1, C4: CP; CP_Elec_6.3x5.7
C2, C3: C; C_0805
D1: D_Schottky_Small; D_SMA_Standard
Feedback: 5k; R_0805
GND IN: CONN_01X02; Socket_Strip_Straight_1x02_Pitch2.54mm
J1: CONN_01X01; Socket_Strip_Straight_1x01_Pitch2.54mm
L1: INDUCTOR_SMALL; L_12x12mm_h4.5mm
P2: CONN_01X02; Socket_Strip_Straight_1x02_Pitch2.54mm
Q1: BSS138; SOT-23
RV1, RV2: POT; Potentiometer_Trimmer_Bourns_3266Y
Radj1: 470; R_0805
U1: LM3485; TSSOP-8_3x3mm_Pitch0.65mm

Connections:
GND: C1.2, C4.2, D1.2, Feedback.2, GND IN.1, P2.2, U1.2, U1.6
unnamed: C1.1, C3.1, GND IN.2, Q1.2, RV2.3, U1.8
unnamed: C2.1, C4.1, L1.2, P2.1, RV1.1
unnamed: C2.2, J1.1, RV1.2, U1.4
unnamed: C3.2, RV2.2, Radj1.2, U1.5
unnamed: D1.1, L1.1, Q1.3, U1.1
unnamed: Q1.1, U1.7
unnamed: Feedback.1, RV1.3
unnamed: RV2.1, Radj1.1
