Wilewee/A3EPS/PCB_Design/1 _ fixed with 07mm vias/LTC4352_IDEALDIODE/LTC4352_IDEALDIODE.kicad_pcb

## KiCad design PCB_Design/1 _ fixed with 07mm vias/LTC4352_IDEALDIODE/LTC4352_IDEALDIODE.kicad_pcb (2018-01-24)

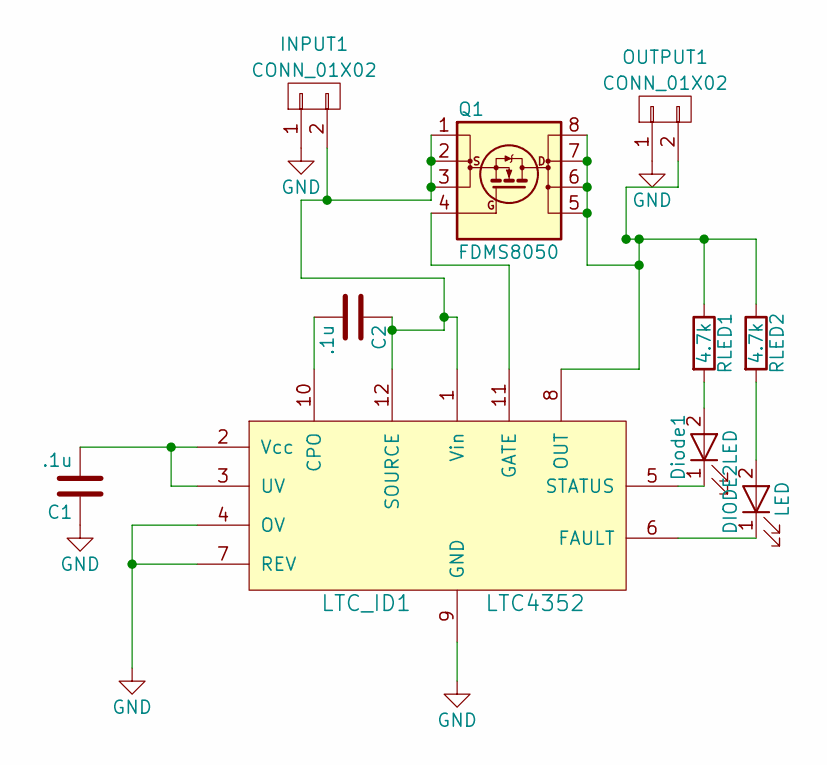
[picture p21: schematic LTC4352_IDEALDIODE.sch]

Parts:
C1, C2: .1u; C_0805
DIODE2: LED; D_0805
Diode1: LED; D_0805
INPUT1: CONN_01X02; Socket_Strip_Straight_1x02_Pitch2.54mm
LTC_ID1: LTC4352; MSOP-12_3x4mm_Pitch0.65mm
OUTPUT1: CONN_01X02; Socket_Strip_Straight_1x02_Pitch2.54mm
Q1: FDMS8050; DFN-8-1EP_6x5mm_Pitch1.27mm_LargeFlag
RLED1, RLED2: 4.7k; LED_0805

Connections:
GND: C1.1, INPUT1.1, LTC_ID1.4 (OV), LTC_ID1.7 (REV), LTC_ID1.9 (GND), OUTPUT1.1
unnamed: C1.2, LTC_ID1.2 (Vcc), LTC_ID1.3 (UV)
unnamed: C2.1, INPUT1.2, LTC_ID1.1 (Vin), LTC_ID1.12 (SOURCE), Q1.1 (S), Q1.2 (S), Q1.3 (S)
unnamed: C2.2, LTC_ID1.10 (CPO)
unnamed: DIODE2.1 (K), LTC_ID1.6 (FAULT)
unnamed: DIODE2.2 (A), RLED2.2
unnamed: Diode1.1 (K), LTC_ID1.5 (STATUS)
unnamed: Diode1.2 (A), RLED1.2
unnamed: LTC_ID1.8 (OUT), OUTPUT1.2, Q1.5 (D), Q1.6 (D), Q1.7 (D), Q1.8 (D), RLED1.1, RLED2.1
unnamed: LTC_ID1.11 (GATE), Q1.4 (G)

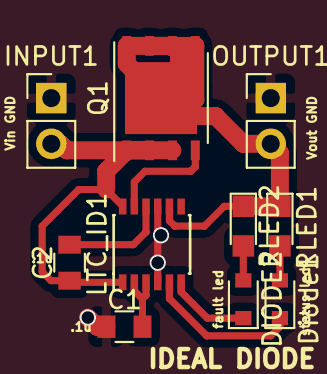
[picture p22: board LTC4352_IDEALDIODE.kicad_pcb from above]

Board: 2 copper layers, 10 parts (0 on the bottom side), 10 nets.
