Wilewee/A3EPS/PCB_Design/1 _ fixed with 07mm vias/BQ29200/BQ29200.kicad_pcb

## KiCad design PCB_Design/1 _ fixed with 07mm vias/BQ29200/BQ29200.kicad_pcb (2018-01-24)

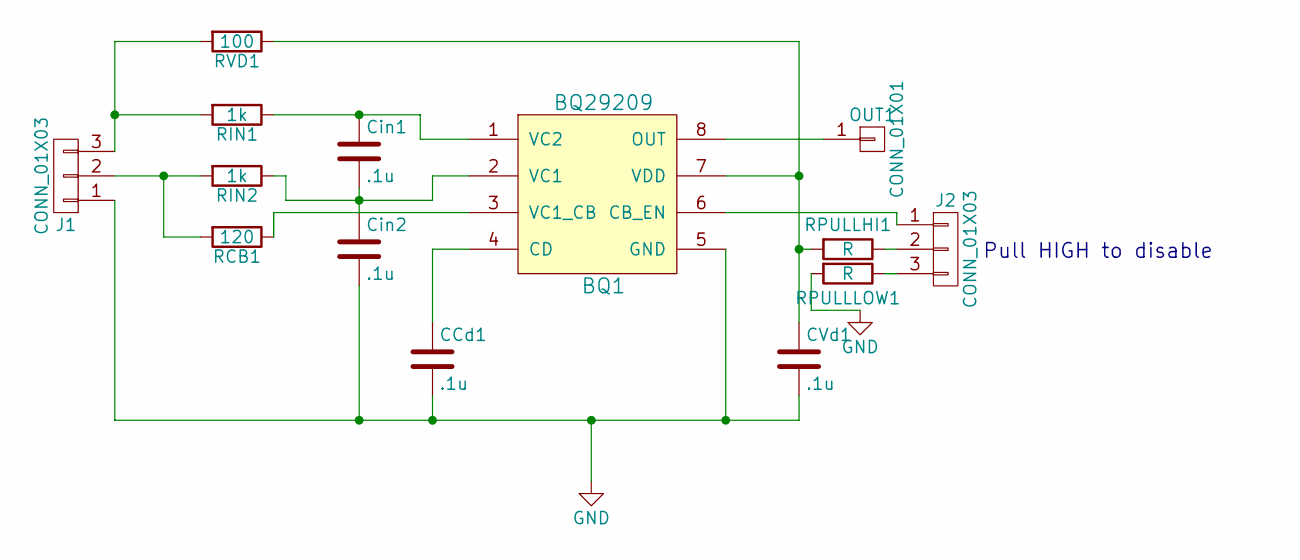
[picture p23: schematic BQ29200.sch]

Parts:
BQ1: BQ29209; DFN-8-1EP_3x3mm_Pitch0.65mm
CCd1: .1u; C_0805
CVd1: .1u; C_0805
Cin1, Cin2: .1u; C_0805
J1, J2: CONN_01X03; Socket_Strip_Straight_1x03_Pitch2.54mm
OUT1: CONN_01X01; Socket_Strip_Straight_1x01_Pitch2.54mm
RCB1: 120; R_0805
RIN1, RIN2: 1k; R_0805
RPULLHI1: R; R_0805
RPULLLOW1: R; R_0805
RVD1: 100; R_0805

Connections:
GND: BQ1.5 (GND), CCd1.2, CVd1.2, Cin2.2, J1.1, RPULLLOW1.2
unnamed: BQ1.1 (VC2), Cin1.1, RIN1.1
unnamed: BQ1.2 (VC1), Cin1.2, Cin2.1, RIN2.1
unnamed: BQ1.3 (VC1_CB), RCB1.1
unnamed: BQ1.4 (CD), CCd1.1
unnamed: BQ1.6 (CB_EN), J2.1
unnamed: BQ1.7 (VDD), CVd1.1, RPULLHI1.2, RVD1.1
unnamed: BQ1.8 (OUT), OUT1.1
unnamed: J1.2, RCB1.2, RIN2.2
unnamed: J1.3, RIN1.2, RVD1.2
unnamed: J2.2, RPULLHI1.1
unnamed: J2.3, RPULLLOW1.1

Notes on the sheet:
Pull HIGH to disable

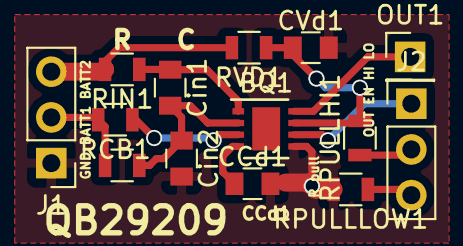
[picture p24: board BQ29200.kicad_pcb from above]

Board: 2 copper layers, 14 parts (0 on the bottom side), 12 nets.
