Wilewee/A3EPS/PCB_Design/1 _ fixed with 07mm vias/max1771_BOOST/max1771.kicad_pcb

## KiCad design PCB_Design/1 _ fixed with 07mm vias/max1771_BOOST/max1771.kicad_pcb (2018-01-24)

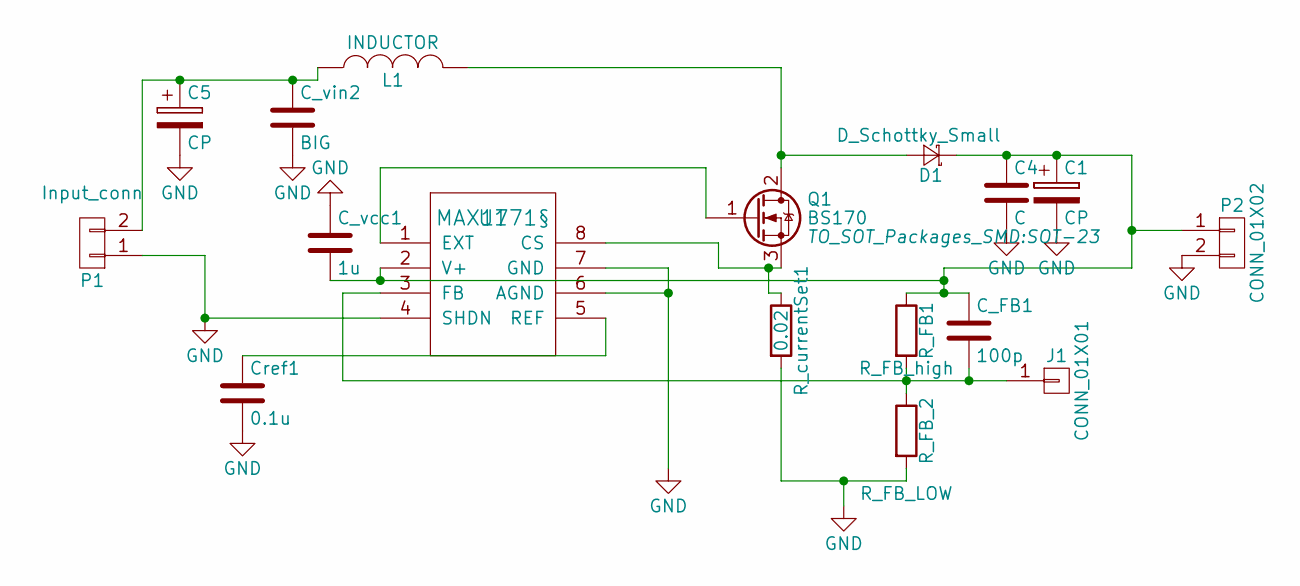
[picture p25: schematic max1771.sch]

Parts:
C1, C5: CP; CP_Tantalum_Case-D_EIA-7343-31_Reflow
C4: C; C_0805
C_FB1: 100p; C_0805
C_vcc1: 1u; C_0805
C_vin2: BIG; C_1210
Cref1: 0.1u; C_0805
D1: D_Schottky_Small; SMA_Handsoldering
J1: CONN_01X01; Socket_Strip_Straight_1x01_Pitch2.54mm
L1: INDUCTOR; Inductor_Taiyo-Yuden_NR-80xx_HandSoldering
P1: Input_conn; Socket_Strip_Angled_2x01
P2: CONN_01X02; Socket_Strip_Angled_2x01
Q1: BS170; SOT-23
R_FB1: R_FB_high; R_0805
R_FB_2: R_FB_LOW; R_0805
R_currentSet1: 0.02; R_1812
U1: MAX1771§; SOIC-8_3.9x4.9mm_Pitch1.27mm

Connections:
GND: C1.2, C4.2, C5.2, C_vcc1.1, C_vin2.2, Cref1.2, P1.1, P2.2, R_FB_2.2, R_currentSet1.2, U1.4 (SHDN), U1.6 (AGND), U1.7 (GND)
unnamed: C1.1, C4.1, C_FB1.1, C_vcc1.2, D1.1 (K), P2.1, R_FB1.1, U1.2 (V+)
unnamed: C5.1, C_vin2.1, L1.1, P1.2
unnamed: C_FB1.2, J1.1, R_FB1.2, R_FB_2.1, U1.3 (FB)
unnamed: Cref1.1, U1.5 (REF)
unnamed: D1.2 (A), L1.2, Q1.2 (D)
unnamed: Q1.1 (G), U1.1 (EXT)
unnamed: Q1.3 (S), R_currentSet1.1, U1.8 (CS)

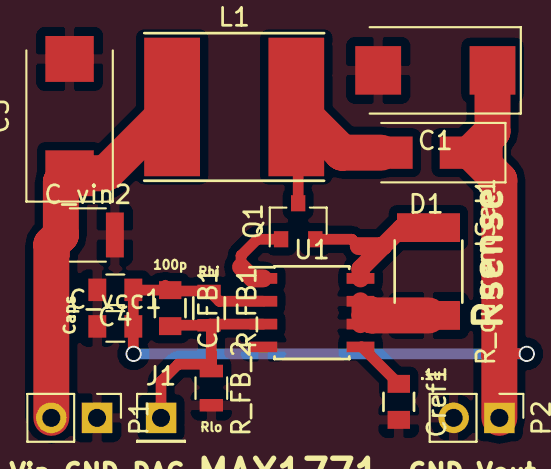
[picture p26: board max1771.kicad_pcb from above]

Board: 2 copper layers, 17 parts (0 on the bottom side), 8 nets.
