Wilewee/A3EPS/PCB_Design/1 _ fixed with 07mm vias/LTC1731-8.2_Charger/LTC1731-8.2.kicad_pcb

## KiCad design PCB_Design/1 _ fixed with 07mm vias/LTC1731-8.2_Charger/LTC1731-8.2.kicad_pcb (2018-01-24)

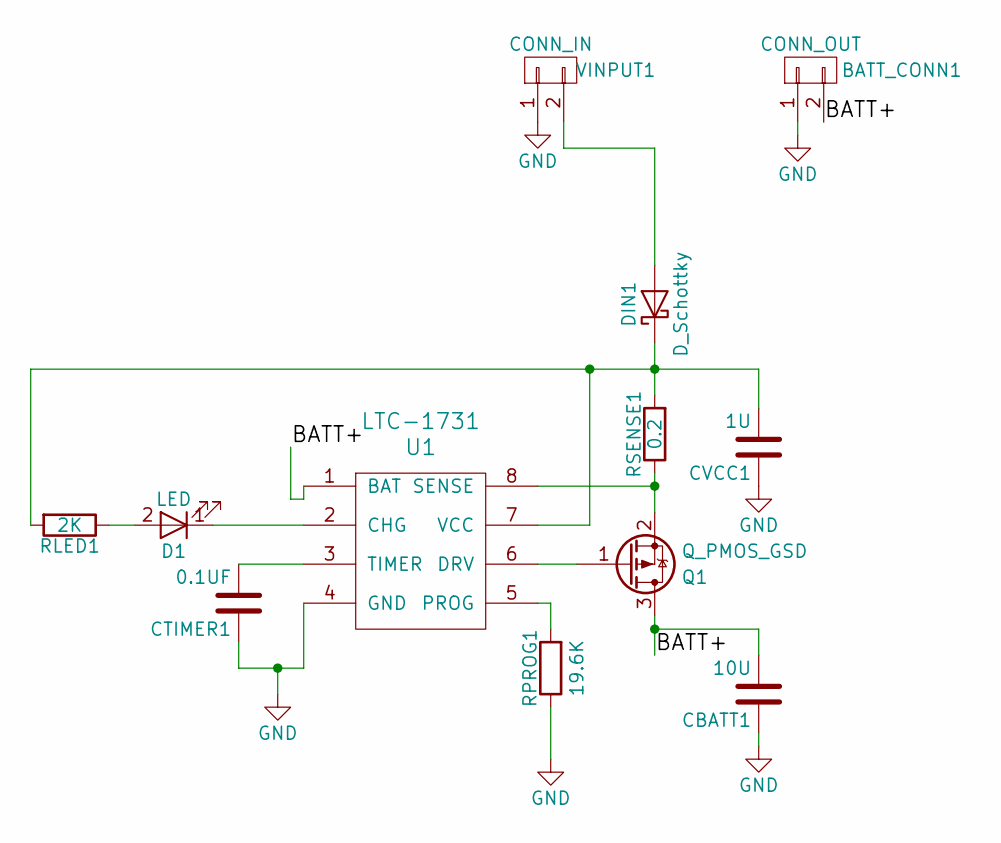
[picture p27: schematic LTC1731-8.2.sch]

Parts:
BATT_CONN1: CONN_OUT; Socket_Strip_Straight_1x02_Pitch2.54mm
CBATT1: 10U; C_1210
CTIMER1: 0.1UF; C_0805
CVCC1: 1U; C_0805
D1: LED; LED_0805
DIN1: D_Schottky; D_SMB_Standard
Q1: Q_PMOS_GSD; SOT-23
RLED1: 2K; R_0805
RPROG1: 19.6K; R_0805
RSENSE1: 0.2; R_0805
U1: LTC-1731; MSOP-8_3x3mm_Pitch0.65mm
VINPUT1: CONN_IN; Socket_Strip_Straight_1x02_Pitch2.54mm

Connections:
/BATT+: BATT_CONN1.2, CBATT1.2, Q1.3 (D), U1.1 (BAT)
GND: BATT_CONN1.1, CBATT1.1, CTIMER1.1, CVCC1.1, RPROG1.1, U1.4 (GND), VINPUT1.1
unnamed: CTIMER1.2, U1.3 (TIMER)
unnamed: CVCC1.2, DIN1.1 (K), RLED1.2, RSENSE1.2, U1.7 (VCC)
unnamed: D1.1 (K), U1.2 (CHG)
unnamed: D1.2 (A), RLED1.1
unnamed: DIN1.2 (A), VINPUT1.2
unnamed: Q1.1 (G), U1.6 (DRV)
unnamed: Q1.2 (S), RSENSE1.1, U1.8 (SENSE)
unnamed: RPROG1.2, U1.5 (PROG)

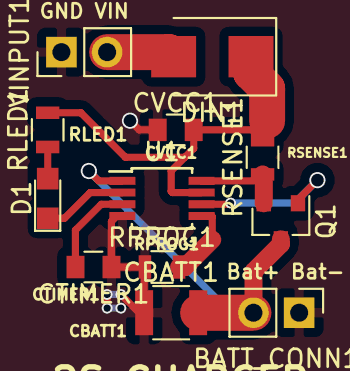
[picture p28: board LTC1731-8.2.kicad_pcb from above]

Board: 2 copper layers, 12 parts (0 on the bottom side), 10 nets.
