Wilewee/A3EPS/PCB_Design/1 _ fixed with 07mm vias/TPS54302_BUCK/TPS54302.kicad_pcb

## KiCad design PCB_Design/1 _ fixed with 07mm vias/TPS54302_BUCK/TPS54302.kicad_pcb (2018-01-24)

Schematic: TPS54302.sch

Parts:
2PIN2: INPUT; Socket_Strip_Straight_1x02_Pitch2.54mm
CBulk1: C; C_1210
CBulk2: C; CP_Tantalum_Case-D_EIA-7343-31_Hand
CVCCbuck1: 10u; C_1210
Cboot1: .1uF; C_1210
Inductor1: L; L_12x12mm_h4.5mm
J1: CONN_01X03; Socket_Strip_Straight_1x03_Pitch2.54mm
R_fb_hi1: R; R_0603_HandSoldering
R_fb_lo1: R; R_0603_HandSoldering
U1: TPS54302; SOT-23-6_Handsoldering

Connections:
GND: 2PIN2.2, CBulk1.2, CBulk2.2, CVCCbuck1.2, J1.1, R_fb_lo1.2, U1.1 (GND)
unnamed: 2PIN2.1, CBulk1.1, CBulk2.1, Inductor1.2, R_fb_hi1.1
unnamed: CVCCbuck1.1, J1.2, U1.3 (VIN)
unnamed: Cboot1.1, U1.6 (BOOT)
unnamed: Cboot1.2, Inductor1.1, U1.2 (SW)
unnamed: J1.3, U1.5 (EN)
unnamed: R_fb_hi1.2, R_fb_lo1.1, U1.4 (FB)

Notes on the sheet:
Float EN to enable Pull LOW to disable MIGHT BE GOOD TO USE AS OUTPUT CONTROL?

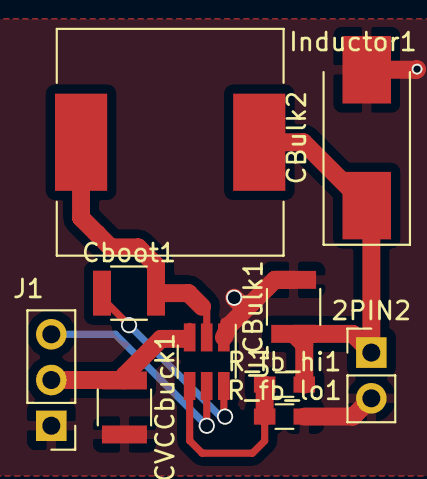
[picture p29: board TPS54302.kicad_pcb from above]

Board: 2 copper layers, 10 parts (0 on the bottom side), 7 nets.
