Wilewee/A3EPS/PCB_Design/1 _ fixed with 07mm vias/INA139/INA139.kicad_pcb

## KiCad design PCB_Design/1 _ fixed with 07mm vias/INA139/INA139.kicad_pcb (2018-01-24)

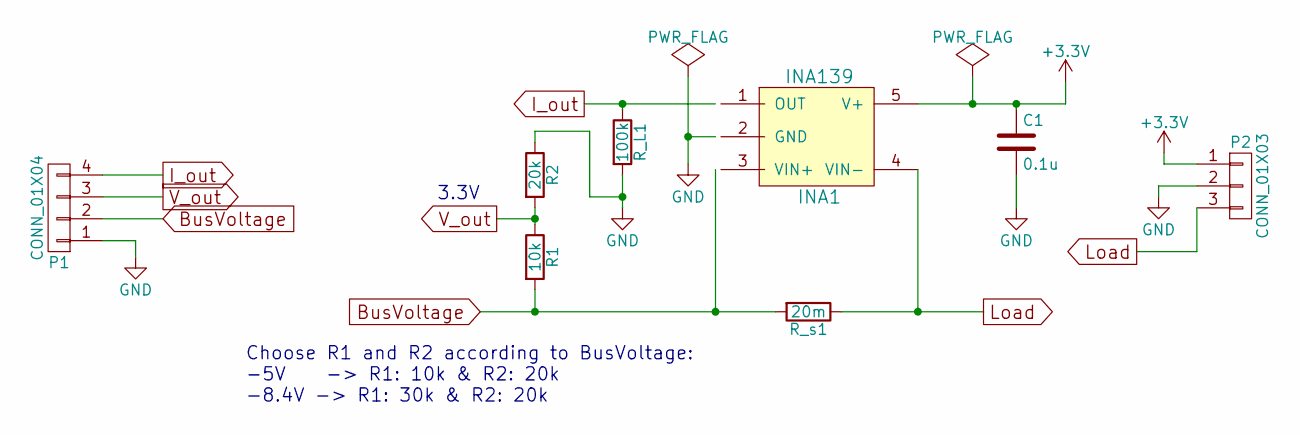
[picture p30: schematic INA139.sch, INA139 & Voltage Divider for Voltage Measurement]

Parts:
C1: 0.1u; C_0805_HandSoldering
INA1: INA139; SOT-23-5
P1: CONN_01X04; JST_XH_B04B-XH-A_04x2.50mm_Straight
P2: CONN_01X03; JST_XH_B03B-XH-A_03x2.50mm_Straight
R1: 10k; R_0805_HandSoldering
R2: 20k; R_0805_HandSoldering
R_L1: 100k; R_0805_HandSoldering
R_s1: 20m; R_1206_HandSoldering

Connections:
+3V3: C1.1, INA1.5 (V+), P2.1
BusVoltage: INA1.3 (VIN+), P1.2, R1.2, R_s1.2
GND: C1.2, INA1.2 (GND), P1.1, P2.2, R2.1, R_L1.2
I_out: INA1.1 (OUT), P1.4, R_L1.1
Load: INA1.4 (VIN-), P2.3, R_s1.1
V_out: P1.3, R1.1, R2.2

Notes on the sheet:
3.3V
Choose R1 and R2 according to BusVoltage: -5V -> R1: 10k & R2: 20k -8.4V -> R1: 30k & R2: 20k

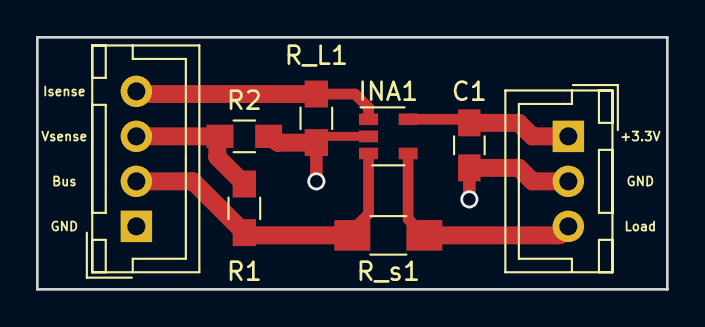
[picture p31: board INA139.kicad_pcb from above]

Board: 2 copper layers, 35.0 x 14.0 mm, 8 parts (0 on the bottom side), 6 nets.
