Wilewee/A3EPS/PCB_Design/1 _ fixed with 07mm vias/LTC3115_BuckBoost/LTC3115.kicad_pcb

## KiCad design PCB_Design/1 _ fixed with 07mm vias/LTC3115_BuckBoost/LTC3115.kicad_pcb (2018-01-24)

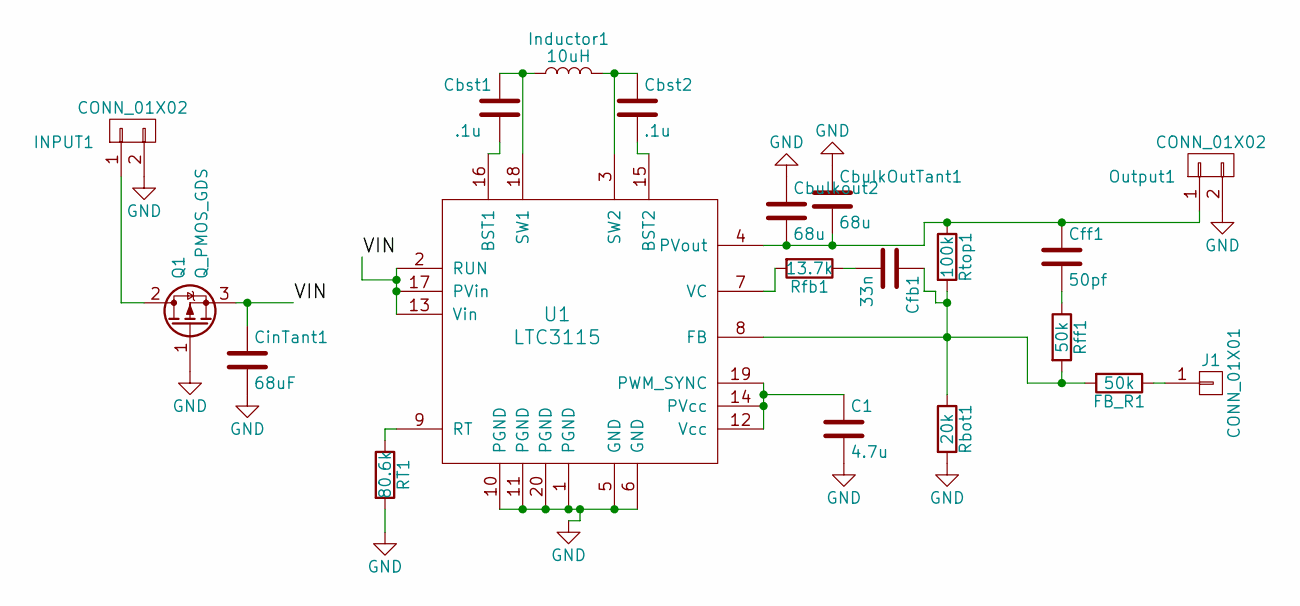
[picture p32: schematic LTC3115.sch]

Parts:
C1: 4.7u; C_0603
Cbst1, Cbst2: .1u; C_0603
CbulkOutTant1: 68u; C_1210
Cbulkout2: 68u; CP_Tantalum_Case-D_EIA-7343-31_Reflow
Cfb1: 33n; C_0603
Cff1: 50pf; C_0603
CinTant1: 68uF; CP_Tantalum_Case-D_EIA-7343-31_Reflow
FB_R1: 50k; R_0603
INPUT1: CONN_01X02; Socket_Strip_Straight_1x02_Pitch2.54mm
Inductor1: 10uH; L_12x12mm_h4.5mm
J1: CONN_01X01; Socket_Strip_Straight_1x01_Pitch2.54mm
Output1: CONN_01X02; Socket_Strip_Straight_1x02_Pitch2.54mm
Q1: Q_PMOS_GDS; SOT-23
RT1: 80.6k; R_0603
Rbot1: 20k; R_0603
Rfb1: 13.7k; R_0603
Rff1: 50k; R_0603
Rtop1: 100k; R_0603
U1: LTC3115; TSSOP-20_4.4x6.5mm_Pitch0.65mm

Connections:
/VIN: CinTant1.1, Q1.3 (S), U1.2 (RUN), U1.13 (Vin), U1.17 (PVin)
GND: C1.2, CbulkOutTant1.1, Cbulkout2.1, CinTant1.2, INPUT1.2, Output1.2, Q1.1 (G), RT1.2, Rbot1.2, U1.1 (PGND), U1.5 (GND), U1.6 (GND), U1.10 (PGND), U1.11 (PGND), U1.20 (PGND)
unnamed: C1.1, U1.12 (Vcc), U1.14 (PVcc), U1.19 (PWM_SYNC)
unnamed: Cbst1.1, Inductor1.1, U1.18 (SW1)
unnamed: Cbst1.2, U1.16 (BST1)
unnamed: Cbst2.1, Inductor1.2, U1.3 (SW2)
unnamed: Cbst2.2, U1.15 (BST2)
unnamed: CbulkOutTant1.2, Cbulkout2.2, Cff1.1, Output1.1, Rtop1.1, U1.4 (PVout)
unnamed: Cfb1.1, FB_R1.2, Rbot1.1, Rff1.2, Rtop1.2, U1.8 (FB)
unnamed: Cfb1.2, Rfb1.1
unnamed: Cff1.2, Rff1.1
unnamed: FB_R1.1, J1.1
unnamed: INPUT1.1, Q1.2 (D)
unnamed: RT1.1, U1.9 (RT)
unnamed: Rfb1.2, U1.7 (VC)

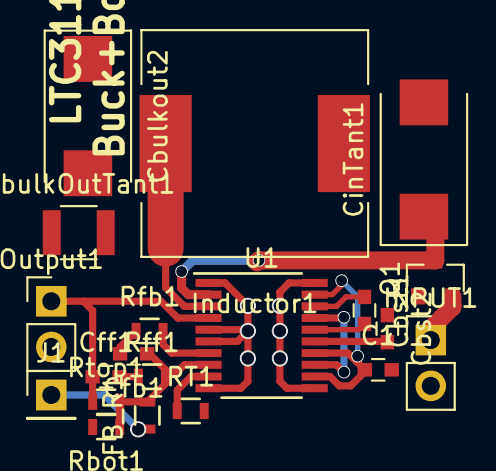
[picture p33: board LTC3115.kicad_pcb from above]

Board: 4 copper layers, 20 parts (0 on the bottom side), 15 nets.
