Wilewee/A3EPS/PCB_Design/1 _ fixed with 07mm vias/Max668_BOOST/Max668_2.kicad_pcb

## KiCad design PCB_Design/1 _ fixed with 07mm vias/Max668_BOOST/Max668_2.kicad_pcb (2018-01-24)

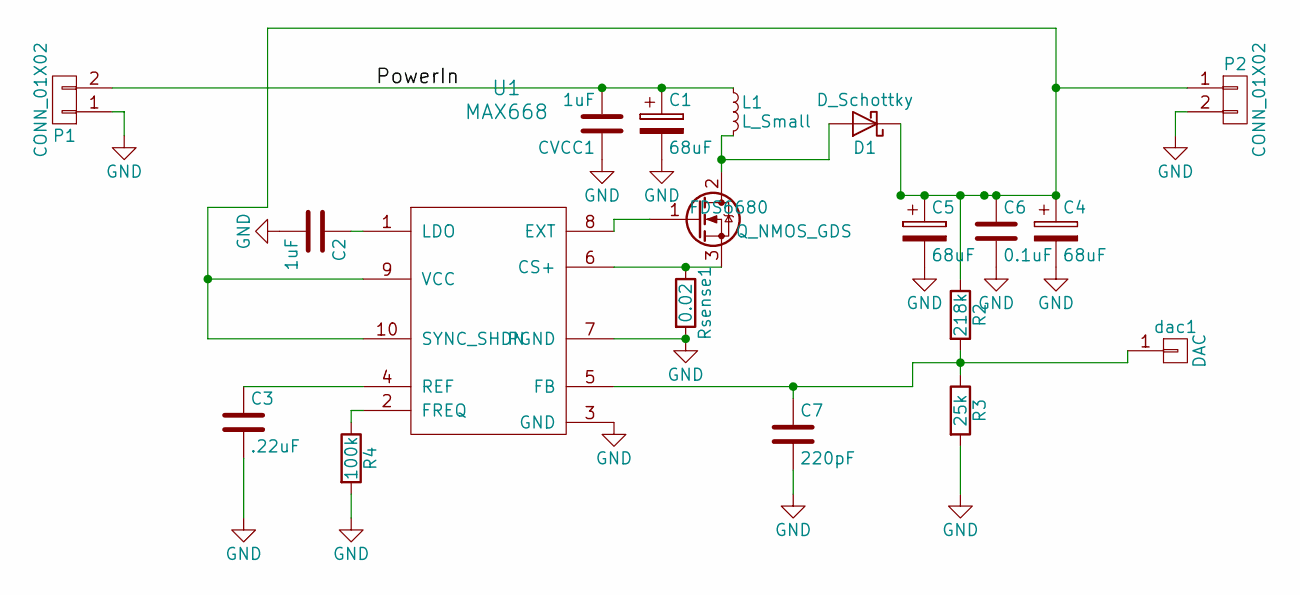
[picture p34: schematic Max668_2.sch]

Parts:
C1, C4: 68uF; CP_Tantalum_Case-V_EIA-7343-20_Reflow
C2: 1uF; C_0805
C3: .22uF; C_0805
C5: 68uF; C_1210
C6: 0.1uF; C_0805
C7: 220pF; C_0805
CVCC1: 1uF; C_1206
D1: D_Schottky; D_SMA_Standard
FDS6680: Q_NMOS_GDS; SOT-23_Handsoldering
L1: L_Small; L_12x12mm_h4.5mm
P1, P2: CONN_01X02; Socket_Strip_Straight_1x02_Pitch2.54mm
R2: 218k; R_0805
R3: 25k; R_0805
R4: 100k; R_0805
Rsense1: 0.02; R_2512
U1: MAX668; MSOP-10_3x3mm_Pitch0.5mm
dac1: DAC; Socket_Strip_Straight_1x01

Connections:
/PowerIn: C1.1, CVCC1.2, L1.1, P1.2
GND: C1.2, C2.2, C3.2, C4.2, C5.2, C6.2, C7.2, CVCC1.1, P1.1, P2.2, R3.2, R4.2, Rsense1.2, U1.3 (GND), U1.7 (PGND)
unnamed: C2.1, U1.1 (LDO)
unnamed: C3.1, U1.4 (REF)
unnamed: C4.1, C5.1, C6.1, D1.1 (K), P2.1, R2.1, U1.9 (VCC), U1.10 (SYNC_SHDN)
unnamed: C7.1, R2.2, R3.1, U1.5 (FB), dac1.1
unnamed: D1.2 (A), FDS6680.2 (D), L1.2
unnamed: FDS6680.1 (G), U1.8 (EXT)
unnamed: FDS6680.3 (S), Rsense1.1, U1.6 (CS+)
unnamed: R4.1, U1.2 (FREQ)

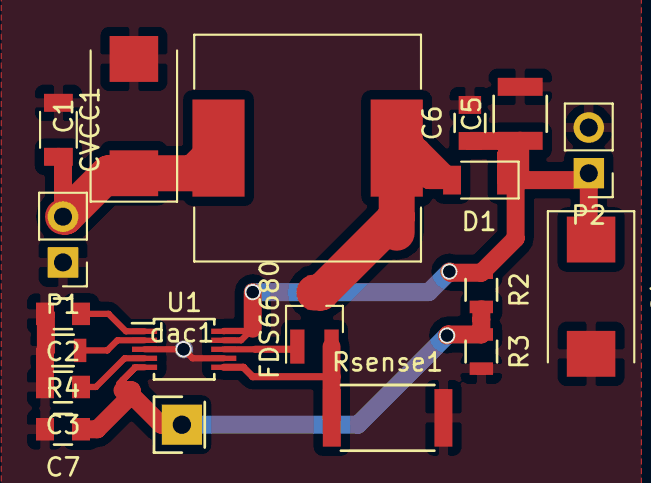
[picture p35: board Max668_2.kicad_pcb from above]

Board: 2 copper layers, 19 parts (0 on the bottom side), 10 nets.
