Wilewee/A3EPS/PCB_Design/1 _ fixed with 07mm vias/Switches/Switches.kicad_pcb

## KiCad design PCB_Design/1 _ fixed with 07mm vias/Switches/Switches.kicad_pcb (2018-01-24)

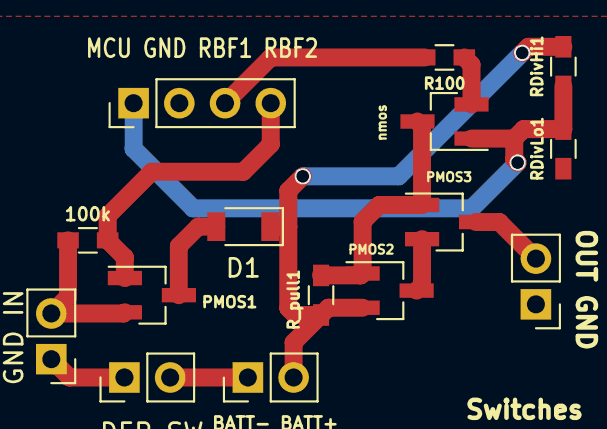
[picture p36: board Switches.kicad_pcb from above]

Board: 2 copper layers, 15 parts (0 on the bottom side), 12 nets.

Parts:
100k: R; R_0603_HandSoldering
D1: D; D_1206
P1: DEP SW; Socket_Strip_Straight_1x02_Pitch2.54mm
P2: BATT- BATT+; Socket_Strip_Straight_1x02_Pitch2.54mm
P3: GND IN; Socket_Strip_Straight_1x02_Pitch2.54mm
P4: MCU GND RBF1 RBF2; Socket_Strip_Straight_1x04_Pitch2.54mm
P5: OUT; Socket_Strip_Straight_1x02_Pitch2.54mm
PMOS1: PCH GDS; SOT-23_Handsoldering
PMOS2, PMOS3: Pch GDS; SOT-23_Handsoldering
R100: R; R_0603_HandSoldering
RDivHi1: R; R_0603_HandSoldering
RDivLo1: R; R_0603_HandSoldering
R_pull1: R; R_0603_HandSoldering
nmos: Logic Nch; SOT-23_Handsoldering

Connections:
BATT+: D1.1, P2.2, PMOS2.2, RDivHi1.2, R_pull1.2
BATT-: P1.2, P2.1
GND: P1.1, P3.1, P4.2, P5.1, RDivLo1.1
LOAD: P5.2, PMOS3.3
MCU_CTRL2: P4.1, RDivHi1.1, RDivLo1.2, nmos.1
unnamed: D1.2, PMOS1.3
unnamed: R100.1, nmos.2
unnamed: PMOS2.1, PMOS3.1, R_pull1.1, nmos.3
unnamed: PMOS2.3, PMOS3.2
RBF_1: 100k.2, P4.4, PMOS1.1
RBF_2: P4.3, R100.2
Vin: 100k.1, P3.2, PMOS1.2
