Wilewee/A3EPS/PCB_Design/1 _ fixed with 07mm vias/LT3080_and_CAN_transceiver/LT3080_and_CAN_transceiver.kicad_pcb

## KiCad design PCB_Design/1 _ fixed with 07mm vias/LT3080_and_CAN_transceiver/LT3080_and_CAN_transceiver.kicad_pcb (2018-01-24)

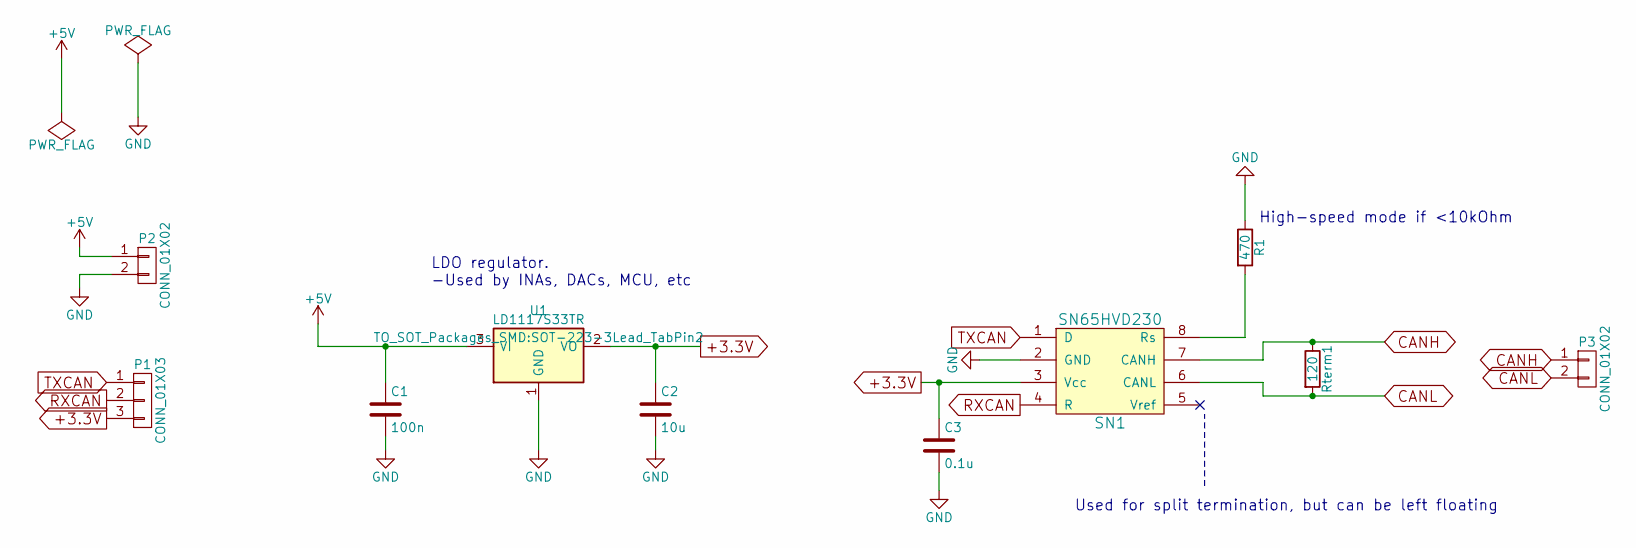
[picture p37: schematic LT3080_and_CAN_transceiver.sch, LT3080 and SN65HVD230]

Parts:
C1: 100n; C_0805_HandSoldering
C2: 10u; C_0805_HandSoldering
C3: 0.1u; C_0805_HandSoldering
P1: CONN_01X03; JST_XH_B03B-XH-A_03x2.50mm_Straight
P2, P3: CONN_01X02; JST_XH_B02B-XH-A_02x2.50mm_Straight
R1: 470; R_0805_HandSoldering
Rterm1: 120; R_0805_HandSoldering
SN1: SN65HVD230; SOIC-8_3.9x4.9mm_Pitch1.27mm
U1: LD1117S33TR; SOT-223-3Lead_TabPin2

Connections:
+3.3V: C2.1, C3.1, P1.3, SN1.3 (Vcc), U1.2 (VO)
+5V: C1.1, P2.1, U1.3 (VI)
CANH: P3.1, Rterm1.1, SN1.7 (CANH)
CANL: P3.2, Rterm1.2, SN1.6 (CANL)
GND: C1.2, C2.2, C3.2, P2.2, R1.1, SN1.2 (GND), U1.1 (GND)
unnamed: R1.2, SN1.8 (Rs)
RXCAN: P1.2, SN1.4 (R)
TXCAN: P1.1, SN1.1 (D)

Notes on the sheet:
LDO regulator. -Used by INAs, DACs, MCU, etc
High-speed mode if <10kOhm
Used for split termination, but can be left floating

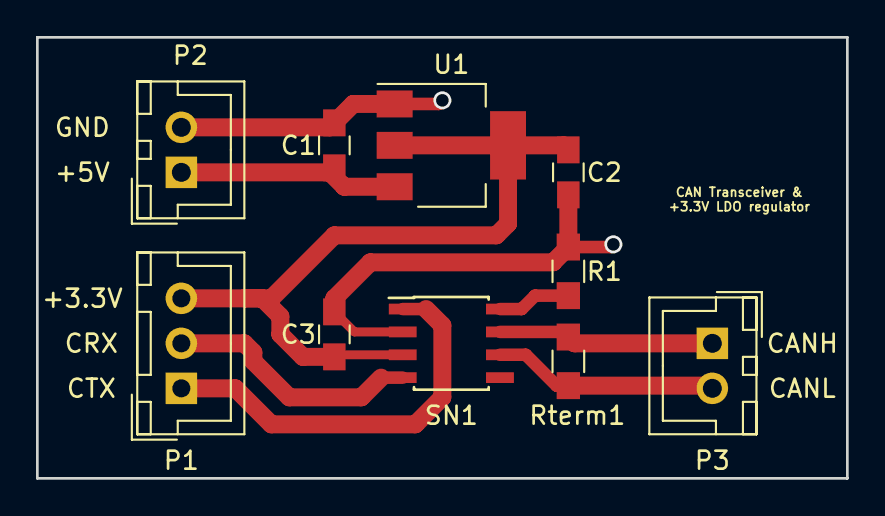
[picture p38: board LT3080_and_CAN_transceiver.kicad_pcb from above]

Board: 2 copper layers, 45.0 x 24.5 mm, 10 parts (0 on the bottom side), 8 nets.
