Wilewee/A3EPS/(commit log)

2017-12-06 Add files via upload
    Project init. This includes many ready subcircuits. Many are missing.
    No PCB layout. Only sch file.
    [BATT.sch, Buck_5.sch, DAC.sch, Diode.sch, External_Charger.sch, Full_PCB.kicad_pcb, Full_PCB.sch, INA139.sch]
2017-12-06 Small modifications to SCH
    [Full_PCB.sch, INA139.sch, Max668_boost.sch]
2018-01-24 SCH files updated
    schematics for bottom layer parts updated
    [5VBuck.sch, BQ29200.kicad_pcb, BQ29200.sch, Boost_Converters.sch, Bottom_side.kicad_pcb, Bottom_side.sch, Combin ed.kicad_pcb, Combin ed.sch]
2018-02-01 Cleaned up folder structure and added IO pinout
    IO pinout can be found in documentation
    [5VBuck.sch, BATT.sch, BQ29200.kicad_pcb, BQ29200.sch, Boost_Converters.sch, Bottom_side.kicad_pcb, Bottom_side.sch, Buck_5.sch]
2018-02-04 PCB bottom layer populated
    PCB bottom layer populated, and waiting for top layer to be merged.
    [5VBuck.sch, BQ29200.kicad_pcb, BQ29200.sch, Battery.sch, Boost_Converters.sch, Bottom_side.kicad_pcb, Bottom_side.sch, Combin ed.kicad_pcb]
2018-02-04 Updated PCB structure tree
    Full_PCB now includes bottom and top layer hierarchical sheets
    [5VBuck.sch, Boost_Converters.sch, Bottom_Layer.sch, Bottom_side.sch, Bottom_sider.sch, Connectors.sch, DAC.sch, Full_PCB.kicad_pcb]
2018-02-06 Updated
    Full pcb updated
    [5VBuck.sch, BATT.sch, Battery.sch, Boost_Converters.sch, Bottom_Layer.sch, Bottom_side.sch, Bottom_sider.sch, Buck_5.sch]
2018-02-11 Add files via upload
    STM32 done. Other modules are work in progress.
    [Boost_converters.sch, Bus_regulation.sch, CAN_transceivers.sch, Connectors.sch, Input.sch, Input_telemetria.sch, Output_telemetria.sch, STM32.kicad_pcb]
2018-02-16 cleaned up
    [5VBuck.sch, BQ29200.kicad_pcb, BQ29200.sch, Battery.sch, Boost_Converters.sch, Bottom_Layer.sch, Bottom_side.kicad_pcb, Bottom_side.sch]
2018-02-16 Add files via upload
    Schema for full EPS R1 uploaded
    [3V6_rail.sch, Battery_pack.sch, Boost_converters.sch, Bus_regulation.sch, CAN_transceivers.sch, Connectors.sch, EPS.sch, Input.sch]
2018-02-19 Updated schematics
    [3V6_rail.sch, Battery_pack.sch, Boost_converters.sch, Bus_regulation.sch, CAN_transceivers.sch, Connectors.sch, EPS.sch, Input.sch]
2018-02-20 Updated Schematics
    Added:
    - digital pot
    - digital loads
    - updated switch sheet to block two ways before battery
    [3V6_rail.sch, Battery_pack.sch, Boost.sch, Boost_converters.sch, Bus_regulation.sch, CAN_transceivers.sch, Connectors_diodes.sch, Current_Limiters.sch]
2018-02-27 Finalized SCH (beta version) and started pcb
    Capacitor banks might need to be reassigned to other locations.
    No RBF pin on this SCH or PCB.
    Battery gound deployment switch is fully mechanical (no mosfet switch on low side).
    PCB of the prototype started. Main power converters and current measuring devices layed out.
    SCH still requires ESD protection diodes!
    [3V6_rail.sch, Battery_pack.sch, Boost.sch, Bus_regulation.sch, CAN_transceivers.sch, Connectors_diodes.sch, Current_Limiters.sch, EPS.kicad_pcb]
2018-02-27 Fixed previous commit
    [Battery_pack.sch, EPS.sch]
2018-02-27 Fixed gnd at Battery_pack.sch
    No global gnd at BP.sch
    [Battery_pack.sch]
2018-02-28 Flowchart added
    Flowchart in png and xml
2018-03-06 PCB updated
    Added testpoints and updated PCB
    [3V6_rail.sch, Battery_pack.sch, Boost.sch, Bus_regulation.sch, CAN_transceivers.sch, Connectors_diodes.sch, Current_Limiters.sch, EPS.kicad_pcb]
2018-03-07 Updated PCB
    PCB requires mcu to be routed.
    Changed to thermistor connector on pcb
    [Battery_pack.sch, EPS.kicad_pcb, Input_telemetria.sch, Output_telemetria.sch, Switches.sch]
